Hardi-St/Zugzielanzeiger_mit_Arduino/Pic/OLED_Stehend_mit_Man.jpg

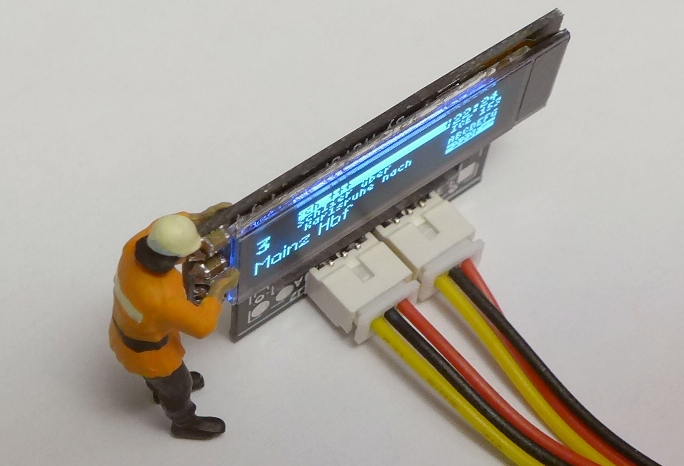
Pic/OLED_Stehend_mit_Man.jpg
