Hardi-St/Zugzielanzeiger_mit_Arduino/Pic/0.87 u 0.91 Zoll Display zusammen.jpg

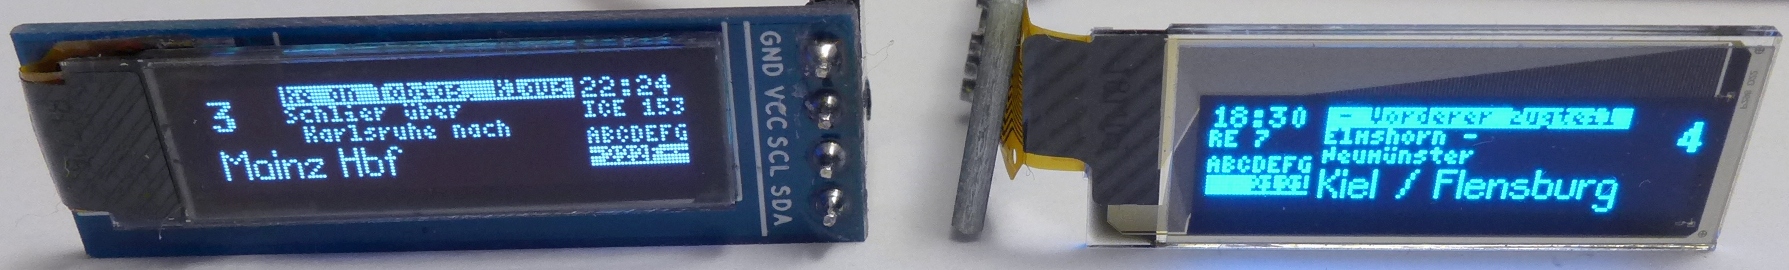
Pic/0.87 u 0.91 Zoll Display zusammen.jpg
