Hardi-St/Zugzielanzeiger_mit_Arduino/README.md

# Zugzielanzeiger_mit_Arduino
Zugzielanzeiger für den Bahnsteig mit Arduino und OLED Display

Siehe: https://www.stummiforum.de/viewtopic.php?f=21&t=131472
