Hardi-St/Zugzielanzeiger_mit_Arduino/Pic/0.87Zoll Disp v Hinten.jpg

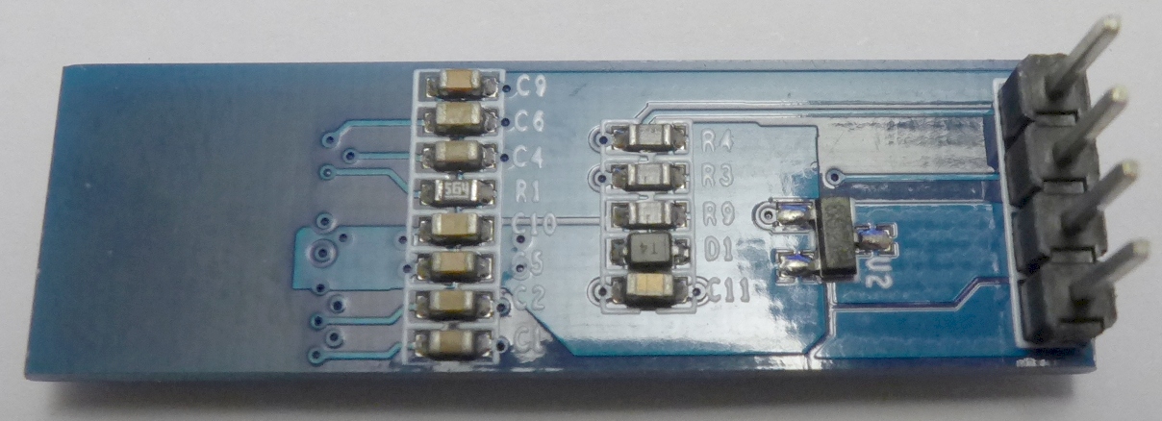
Pic/0.87Zoll Disp v Hinten.jpg
