Hardi-St/Zugzielanzeiger_mit_Arduino/Pic/0.91 Zoll Display.jpg

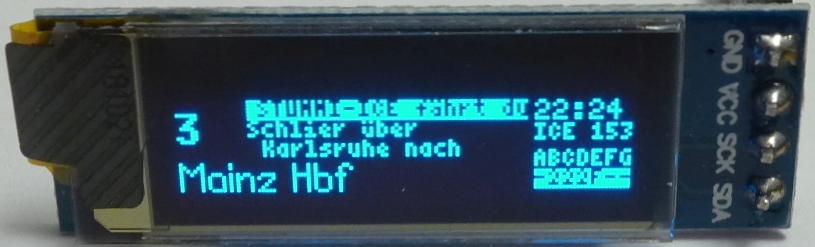
Pic/0.91 Zoll Display.jpg
