Hardi-St/Zugzielanzeiger_mit_Arduino/Pic/Dicke ein Display.PNG

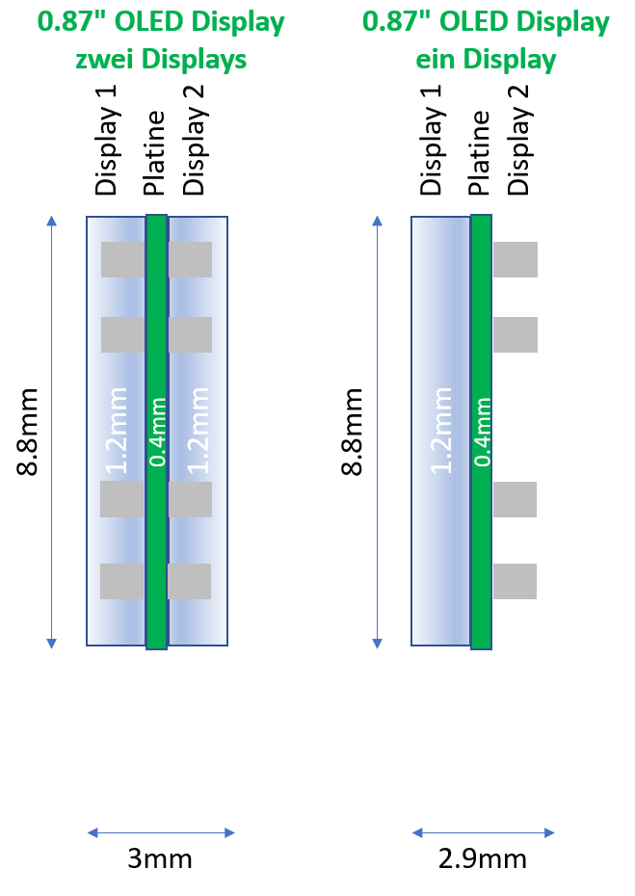
Pic/Dicke ein Display.PNG
