Hardi-St/Zugzielanzeiger_mit_Arduino/Pic/Größenvergleich.PNG

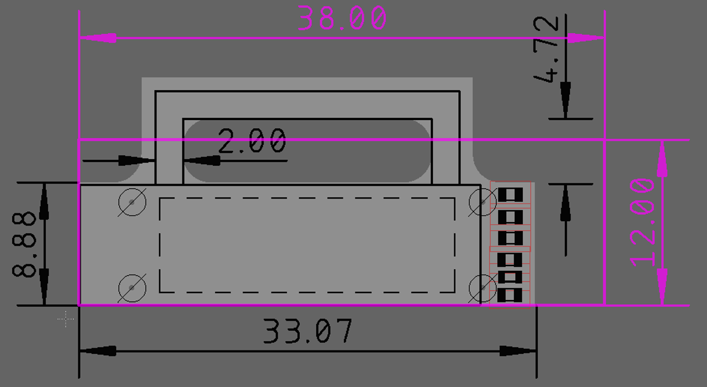
Pic/Größenvergleich.PNG
