Hardi-St/Zugzielanzeiger_mit_Arduino/Pic/OLED_Aufgeklappt.jpg

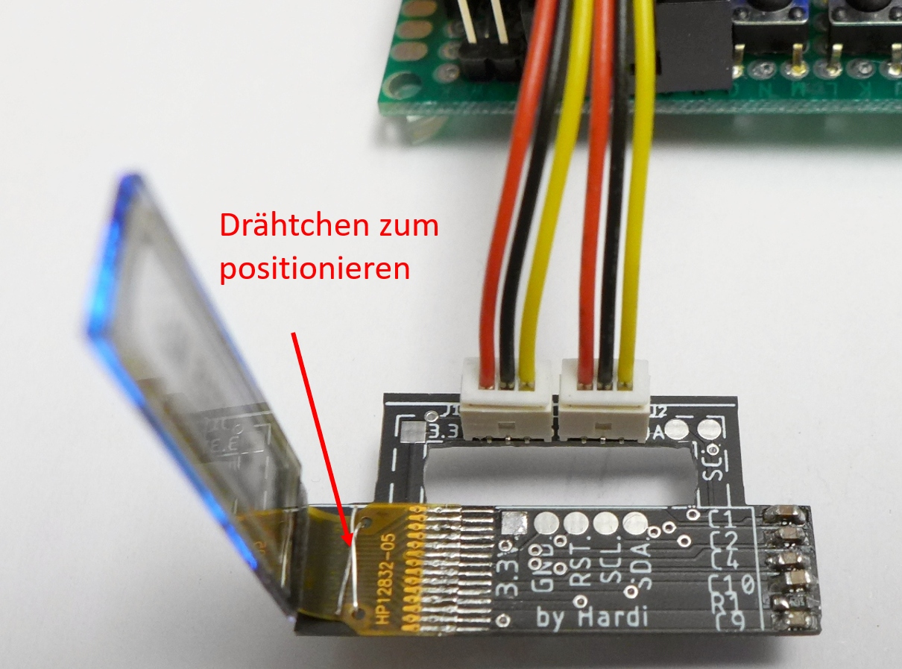
Pic/OLED_Aufgeklappt.jpg
