Hardi-St/Zugzielanzeiger_mit_Arduino/Pic/OLED_Bauteile_Umbau.PNG

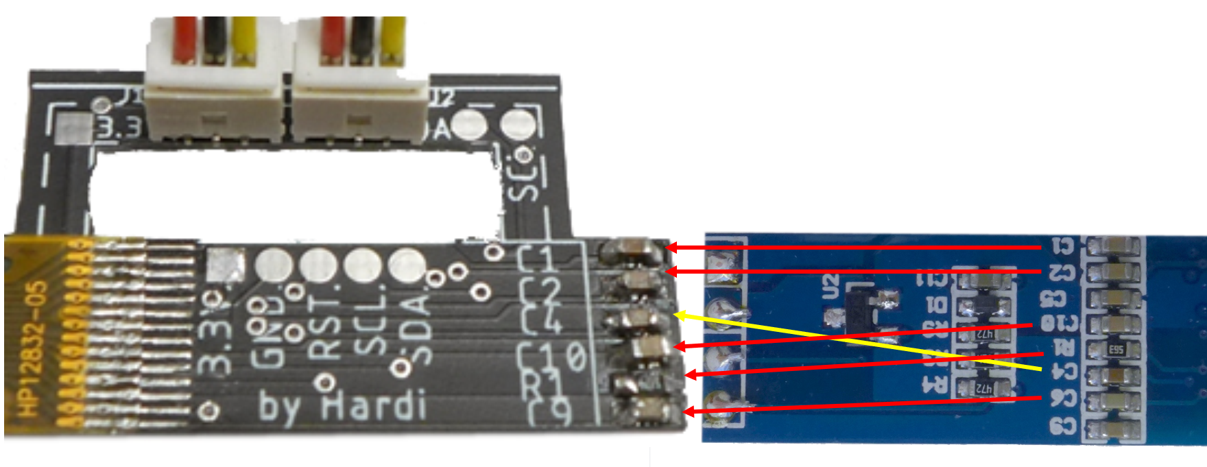
Pic/OLED_Bauteile_Umbau.PNG
