Hardi-St/Zugzielanzeiger_mit_Arduino/Pic/OLED_Umgeklappt.jpg

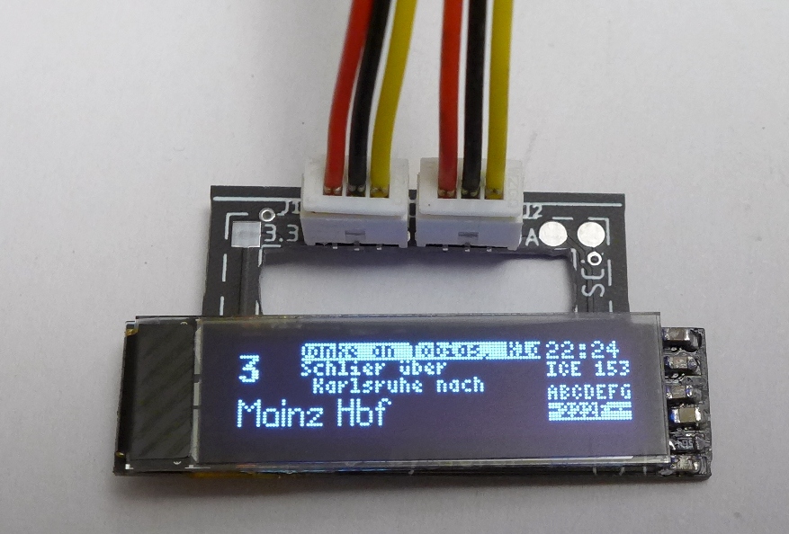
Pic/OLED_Umgeklappt.jpg
