Hardi-St/Zugzielanzeiger_mit_Arduino/Pic/OLED_von_Oben_mit_Mann.jpg

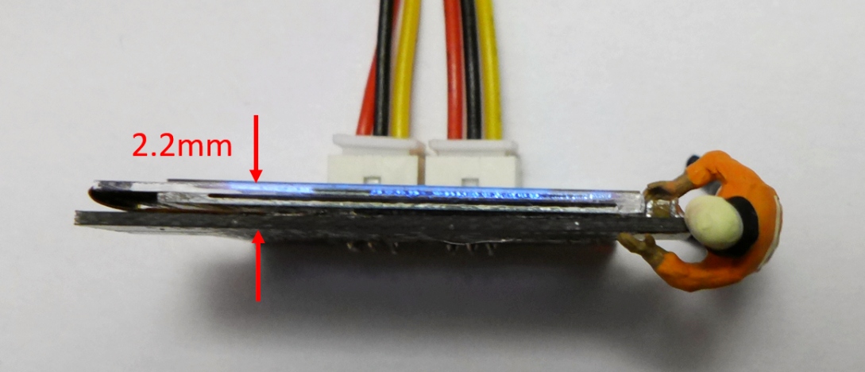
Pic/OLED_von_Oben_mit_Mann.jpg
