Hardi-St/Zugzielanzeiger_mit_Arduino/Pic/Vergleich Dicken.PNG

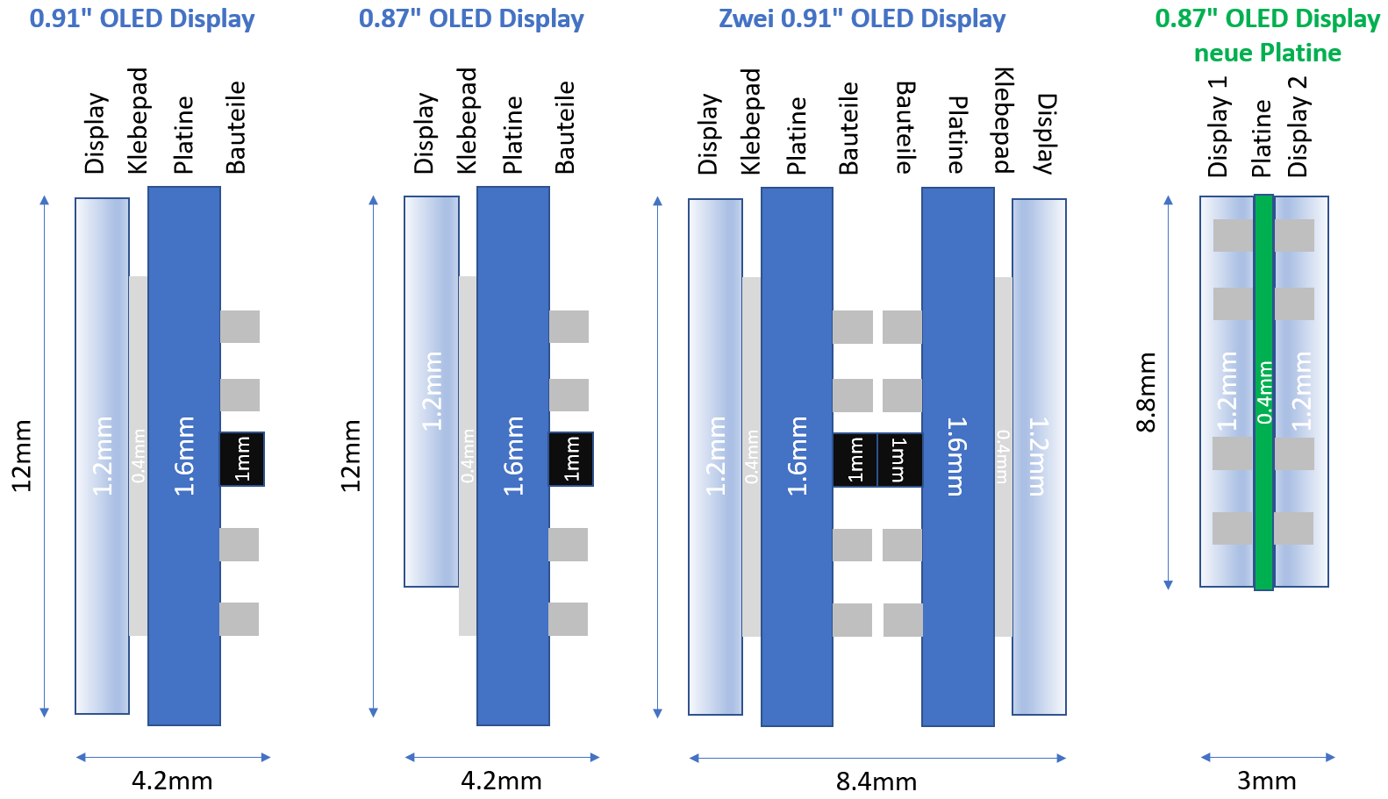
Pic/Vergleich Dicken.PNG
