Hardi-St/Zugzielanzeiger_mit_Arduino/Src/Beta/Bahnsteiganzeige_Hardi/Fonts/6x13B.jpg

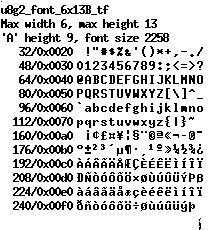
Src/Beta/Bahnsteiganzeige_Hardi/Fonts/6x13B.jpg
