Hardi-St/Zugzielanzeiger_mit_Arduino/Src/Beta/Bahnsteiganzeige_Hardi/Fonts/6x13B_german.jpg

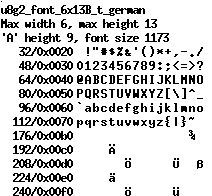
Src/Beta/Bahnsteiganzeige_Hardi/Fonts/6x13B_german.jpg
