Hardi-St/Zugzielanzeiger_mit_Arduino/3D-Gehause/Druckdaten-Zugzielanzeiger/mit_Griff/Case_2xDisplay_087.stl

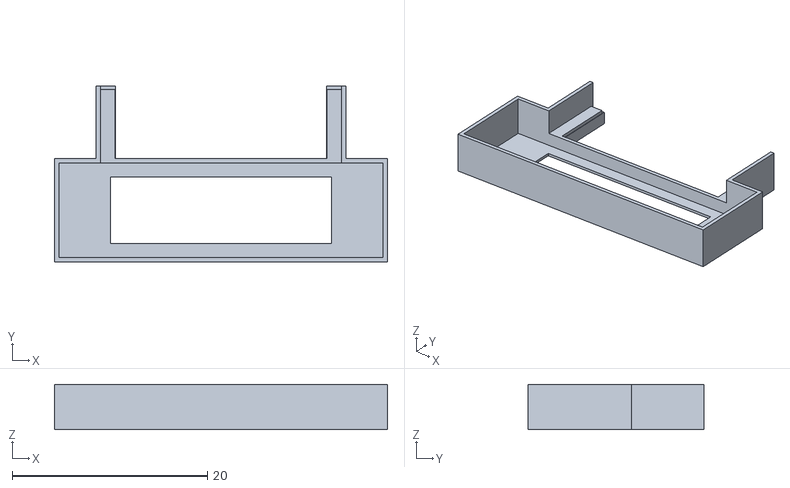
[picture p17: CAD file, 2020-10-04]
3D-Gehause/Druckdaten-Zugzielanzeiger/mit_Griff/Case_2xDisplay_087.stl
34.1 x 18.1 x 4.65
