Hardi-St/Zugzielanzeiger_mit_Arduino/3D-Gehause/Druckdaten-Zugzielanzeiger/mit_Griff/Cover_1xDisplay_087.stl

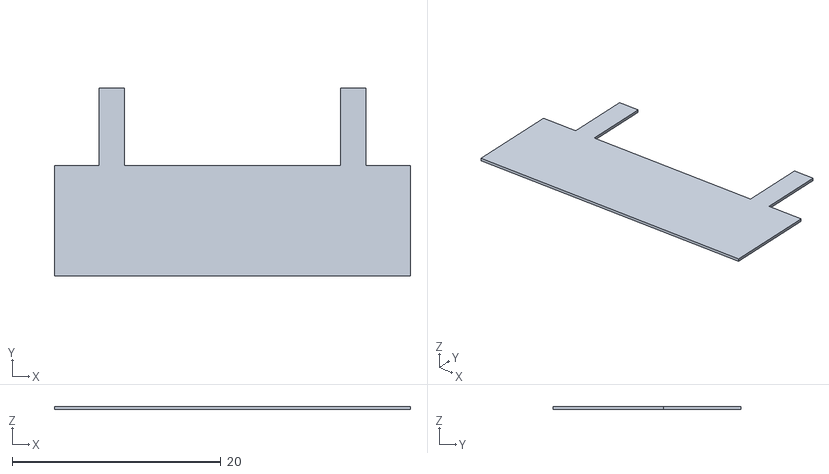
[picture p18: CAD file, 2020-10-04]
3D-Gehause/Druckdaten-Zugzielanzeiger/mit_Griff/Cover_1xDisplay_087.stl
34.1 x 18.1 x 0.3
