Hardi-St/Zugzielanzeiger_mit_Arduino/Platinen/Bestueckungsanleitungen/760DE_Bahnsteigs-Anzeige-OLED_mit_1x_Display.pdf

2021/03/30 13:03 | 1/11 | 760DE Bahnsteigs-Anzeige OLED mit 1 Display

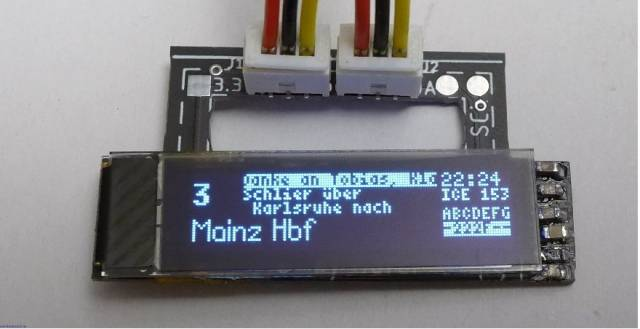
[picture p19: figure]

MobaLedLib Wiki - https://wiki.mobaledlib.de/

# 760DE Bahnsteigs-Anzeige OLED mit 1 Display

Last update: 2021/03/30 12:47 | anleitungen:oled:760de_1xdisplay https://wiki.mobaledlib.de/anleitungen/oled/760de_1xdisplay
https://wiki.mobaledlib.de/ | Printed on 2021/03/30 13:03

## Stückliste

Nachfolgend findet man die Stückliste der notwendigen Bauteile inkl der Bestellnummern bei Reichelt. Man kann allerdings auch anstelle dem einzelnen Display, ein Display mit Platine (https://de.aliexpress.com/item/4000182887362.html) kaufen und die notwendigen Bauteile von dieser ablöten und verwenden.

Anzahl Bezeichnung | | Beschreibung | Bestellnummer | Alternativen, Bemerkungen
1 | Board | Platine | ALF 760-BSt_Anzeige_OLED 1x Display
2 | C1, C2 | Vielschicht-Kerko, 1.0 µF, SMD-0603 | KEM X5R0603 1,0U (https://www.reichelt.de/vielschicht-kerko-1-0-f-25v-85-c-kem-x5r0603-1-0u-p207006.html)
1 | C4 | Vielschicht-Kerko, 2,2µF, 25V, SMD-0603 | KEM X5R0603 2,2U (https://www.reichelt.de/vielschicht-kerko-2-2-f-10v-85-c-kem-x5r0603-2-2u-p207007.html)
2 | C9, C10 | Vielschicht-Kerko, 4,7µF, 25V, SMD-0603 | KEM X5R0603 4,7U (https://www.reichelt.de/vielschicht-kerko-4-7-f-10v-85-c-kem-x5r0603-4-7u-p207009.html)
1 | R1 | SMD-Widerstand, 0603, 560 kOhm, 100mW | SMD-0603 560K (https://www.reichelt.de/smd-widerstand-0603-560-kohm-100-mw-1--smd-0603-560k-p89463.html)
1 | OLED1 | OLED display, 14pin, 128*32, IIC, 0,87 | AliExpress (https://de.aliexpress.com/item/32847458610.html)
2 | J1, J3 | JST Mini Micro, RM 1,25mm, 3-polig | AliExpress (https://de.aliexpress.com/item/32907978236.html) | Alternative: 1x JST Mini Micro, RM 1,25mm, 6-polig (https://de.aliexpress.com/item/32907978236.html)

2021/03/30 13:03 | 3/11 | 760DE Bahnsteigs-Anzeige OLED mit 1 Display

## Bestückung - Aufbauanleitung

Auslöten von der original Platine

Kondensatoren und Widerstände

Dieser Schritt ist nur notwendig, wenn man sich dafür entscheiden hat, die notwendigen Kondensatoren, Widerstände und das Display von der Komplettplatine zu verwenden. Das Entfernen der Bauteile von der Platine geht ganz leicht.
Dazu einfach das Lötzinn auf einer Seite schmelzen und mit Entlötlitze das flüssige Lötzinn entfernen. Nun kann man mit einer Pinzette das Bauteil greifen und auf der anderen Seite des Bauteils das Lötzinn verflüssigen und das Bauteil vorsichtig abheben. Danach unbedingt merken welches Bauteil es war oder in einen Behälter mit Deckel und Beschriftung geben. Die Kondensatoren sind leider nicht ausreichend beschriftet um zu erkennen, welchen Wert diese haben.

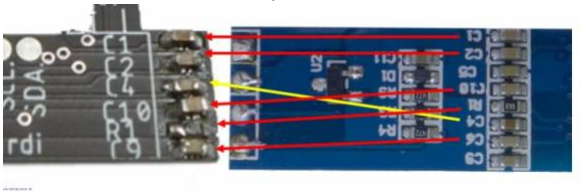
[picture p20: figure]

Display

Das ablöten des Displays ist gar kein Problem. Zum auslöten verzinnt man die Kontakte noch mal neu und erwärmt dann mehrere gleichzeitig vom Rand aus während man die Flexleiterplatte vorsichtig anhebt.

Bearbeiten der Platine

Damit die Platine in die dünnen Halterungen der Bahnsteiganzeige passt, muss die Platine mit einer guten und kleinen Schlüsselfeile bearbeitet werden. Dies ist notwendig, da der Hersteller der Platinen keine Rundungen kleiner 4mm ausfräsen kann. Auf dem nachfolgenden Bild ist oben die Platine im Originalzustand, unten die bereits bearbeitete Platine. Besondere vorsichtig ist an der Oberseite der Platine zu beachten. Dort liegen die Leiterbahnen sehr dicht an der Außenseite und können daher leicht beschädigt werden.

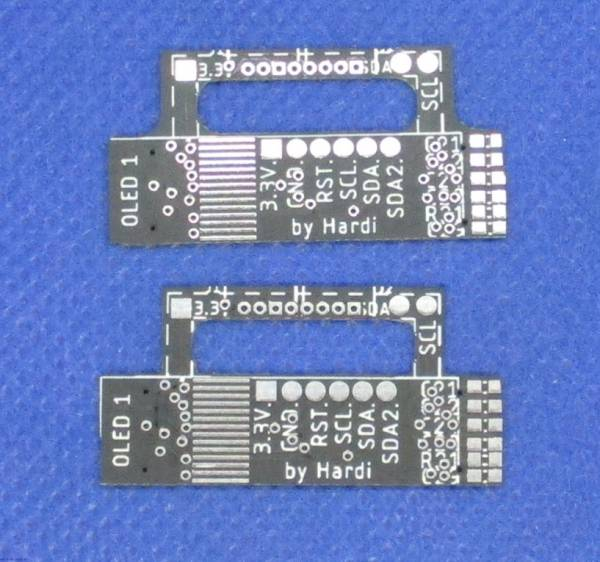
[picture p21: figure]
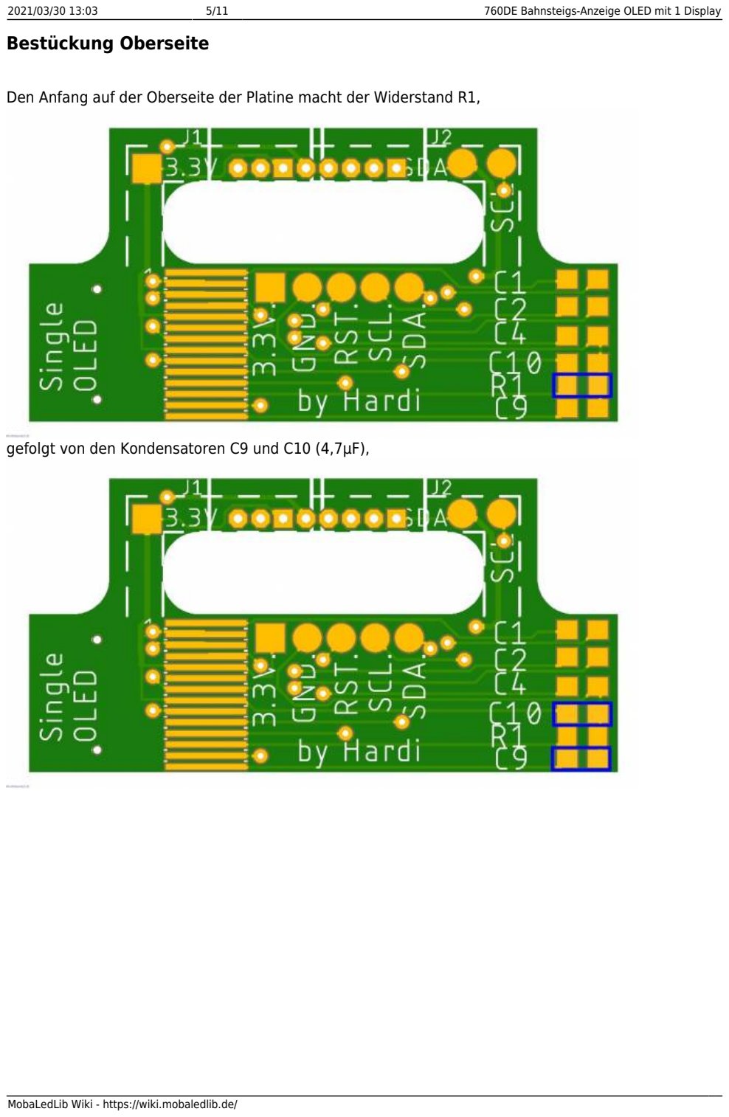
[picture p22: page 5]

2021/03/30 13:03 | 5/11 | 760DE Bahnsteigs-Anzeige OLED mit 1 Display
Bestückung Oberseite

Den Anfang auf der Oberseite der Platine macht der Widerstand R1,

gefolgt von den Kondensatoren C9 und C10 (4,7µF),

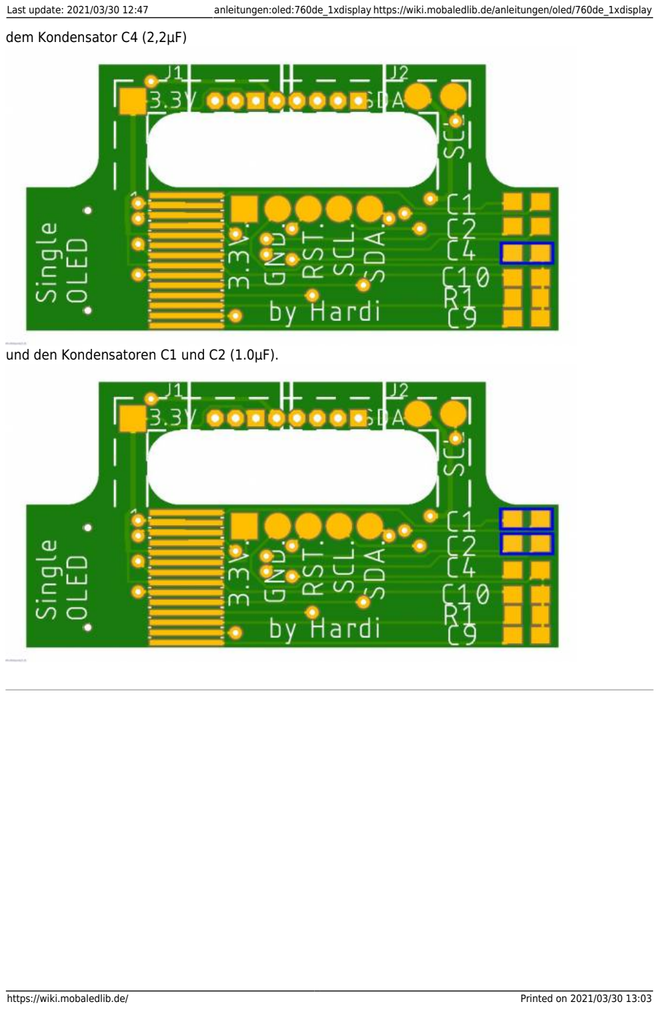
[picture p23: page 6]

dem Kondensator C4 (2,2µF)

und den Kondensatoren C1 und C2 (1.0µF).

2021/03/30 13:03 | 7/11 | 760DE Bahnsteigs-Anzeige OLED mit 1 Display

Sollte zwischen den Kontakten der Leiterbahn ein Verbindung durch Lötzinn entstehen, das Lötzinn mit einer schnellen Bewegung des Lötkolbens in Richtung der Platinenmitte wegschieben. Dort ist ein entfernen des überschüssigen Lötzinns ohne größere Problem möglich.

Zum Anlöten wurden auf der Platine zwei kleine Löcher vorgesehen durch die man einen Draht steckt. Mit diesen wird dann das Displayflexkabel an der richtigen Position fixiert. Dann muss man nur noch winzige Korrekturen machen und kann die Leiterbahnen verbinden. Dazu mit der obersten Leiterbahn beginnen und schauen das diese nach dem anlöten noch sauber ausgerichtet ist. Erst nachdem die Position passt, kann die nächsten Kontakte mit winzigen Mengen Zinn verlöten.

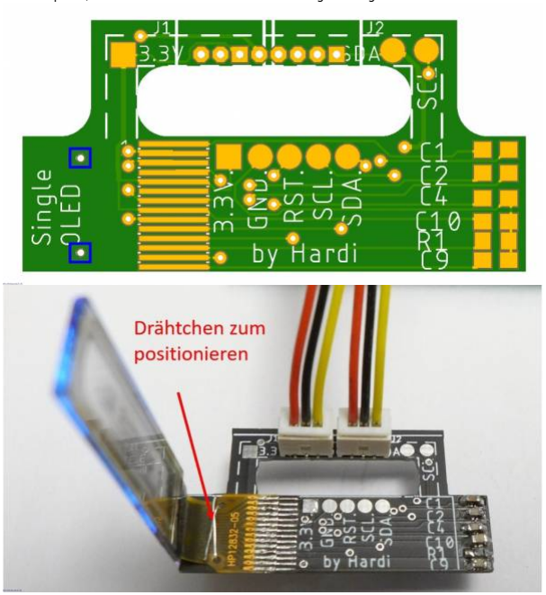
[picture p24: figure]
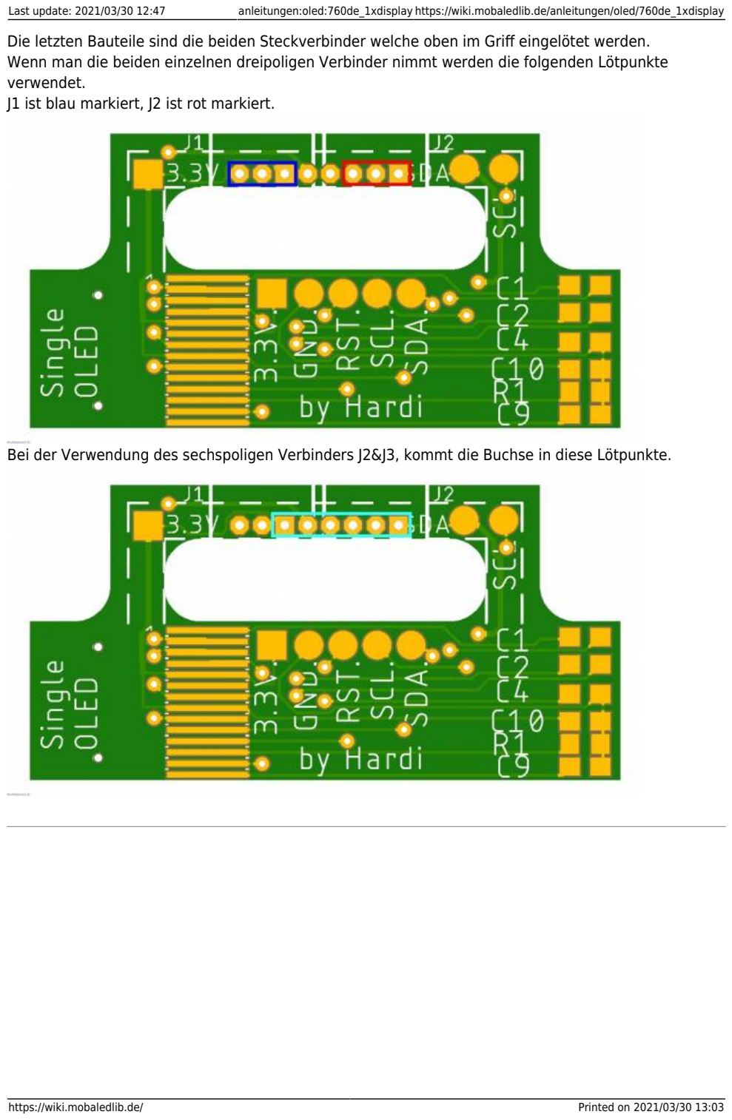
[picture p25: page 8]

Die letzten Bauteile sind die beiden Steckverbinder welche oben im Griff eingelötet werden. Wenn man die beiden einzelnen dreipoligen Verbinder nimmt werden die folgenden Lötpunkte verwendet.
J1 ist blau markiert, J2 ist rot markiert.

Bei der Verwendung des sechspoligen Verbinders J2&J3, kommt die Buchse in diese Lötpunkte.

2021/03/30 13:03 | 9/11 | 760DE Bahnsteigs-Anzeige OLED mit 1 Display
Die Belegung der Kontakt ist wie auf dem nachfolgenden Bildern beschrieben. SDA2 wird dabei für die Platine mit 1x Display nicht benötigt und muss nicht verbunden werden.

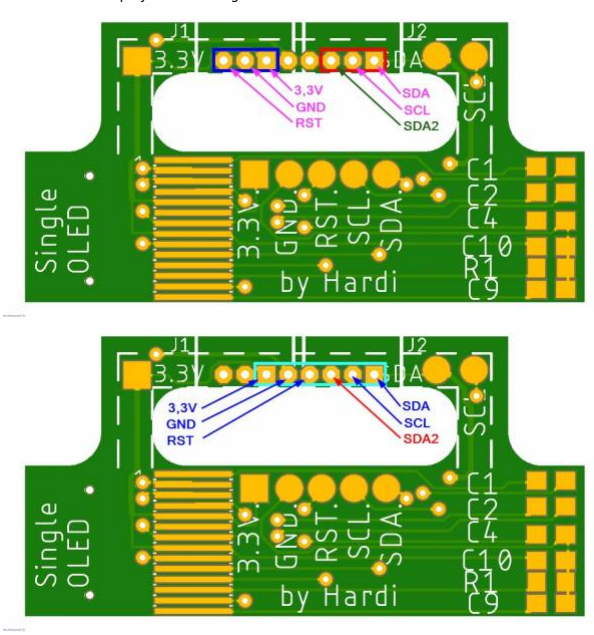
[picture p26: figure]
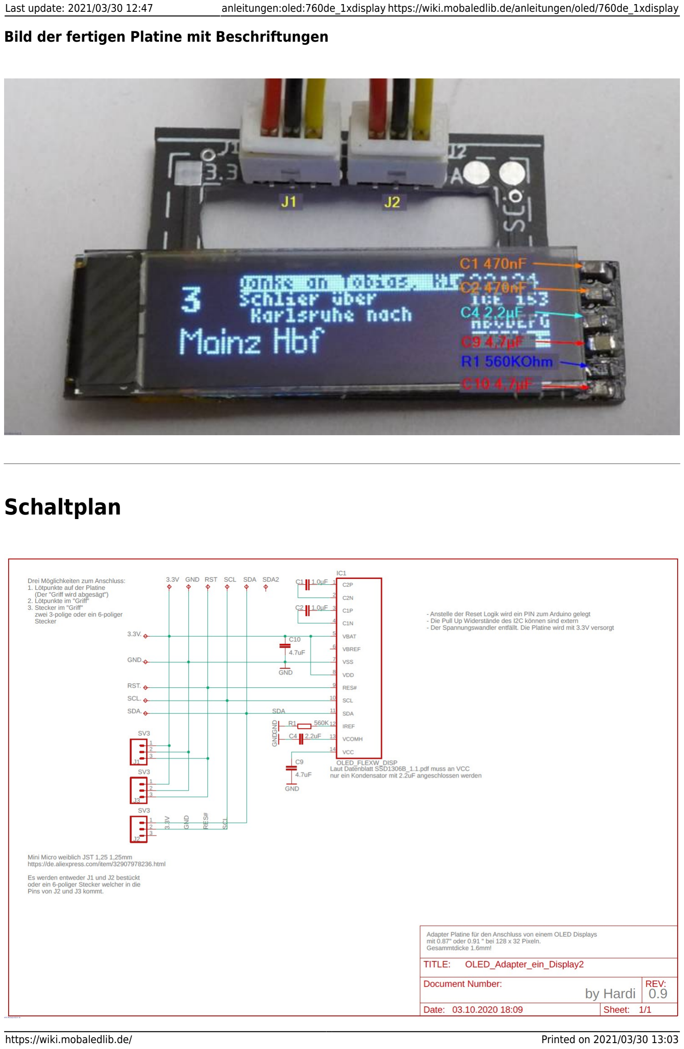
[picture p27: page 10]

Bild der fertigen Platine mit Beschriftungen

## Schaltplan

2021/03/30 13:03 | 11/11 | 760DE Bahnsteigs-Anzeige OLED mit 1 Display

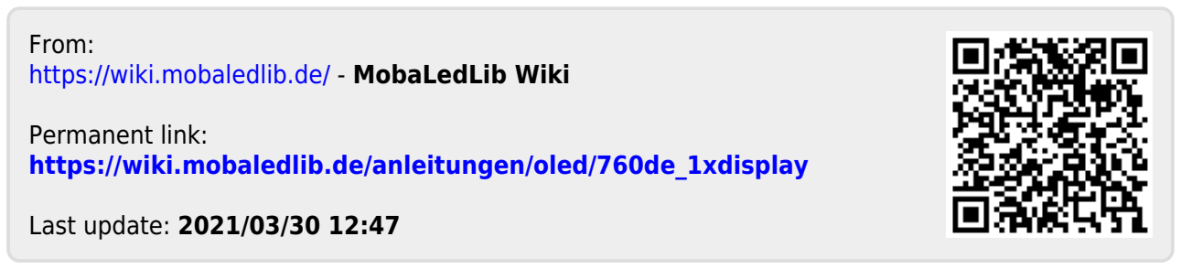
[picture p28: figure]
From: https://wiki.mobaledlib.de/ - MobaLedLib Wiki; Permanent link: https://wiki.mobaledlib.de/anleitungen/oled/760de_1xdisplay; Last update: 2021/03/30 12:47
