Hardi-St/Zugzielanzeiger_mit_Arduino/Platinen/Bestueckungsanleitungen/760DE_Bahnsteigs-Anzeige-OLED_mit_2x_Display.pdf

2021/03/28 08:15 | 1/14 | 760DE Bahnsteigs-Anzeige OLED mit 2 Display

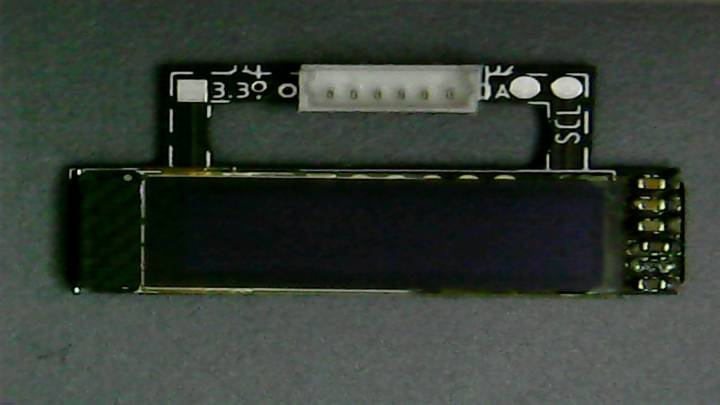
[picture p29: figure]

MobaLedLib Wiki - https://wiki.mobaledlib.de/

# 760DE Bahnsteigs-Anzeige OLED mit 2 Display

Last update: 2021/03/28 08:15 | anleitungen:oled:760de_2xdisplay https://wiki.mobaledlib.de/anleitungen/oled/760de_2xdisplay
https://wiki.mobaledlib.de/ | Printed on 2021/03/28 08:15

## Stückliste

Nachfolgend findet man die Stückliste der notwendigen Bauteile inkl der Bestellnummern bei Reichelt. Man kann allerdings auch anstelle dem einzelnen Display, ein Display mit Platine (https://de.aliexpress.com/item/4000182887362.html) kaufen und die notwendigen Bauteile von dieser ablöten und verwenden.

Anzahl | Bezeichnung | Beschreibung | Bestellnummer | Alternativen, Bemerkungen
1 | Board | Platine | ALF 760-BSt_Anzeige_OLED 1x Display
4 | C1, C2, C21, C22 | Vielschicht-Kerko, 1.0 µF, SMD-0603 | KEM X5R0603 1,0U (https://www.reichelt.de/vielschicht-kerko-1-0-f-25v-85-c-kem-x5r0603-1-0u-p207006.html)
2 | C4, C24 | Vielschicht-Kerko, 2,2µF, SMD-0603 | KEM X5R0603 2,2U (https://www.reichelt.de/vielschicht-kerko-2-2-f-10v-85-c-kem-x5r0603-2-2u-p207007.html)
4 | C9, C10, C20, C29 | Vielschicht-Kerko, 4,7µF, 25V, SMD-0603 | KEM X5R0603 4,7U (https://www.reichelt.de/vielschicht-kerko-4-7-f-10v-85-c-kem-x5r0603-4-7u-p207009.html)
2 | R1, R21 | SMD-Widerstand, 560K, SMD-0603, 100mW | SMD-0603 560K (https://www.reichelt.de/smd-widerstand-0603-560-kohm-100-mw-1--smd-0603-560k-p89463.html)
2 | OLED1 | OLED display, 14pin, 128*32, IIC, 0,87 | AliExpress (https://de.aliexpress.com/item/32847458610.html)
2 | J1, J3 | JST Mini Micro, RM 1,25mm, 3-polig | AliExpress (https://de.aliexpress.com/item/32907978236.html) | Alternative: 1x JST Mini Micro, RM 1,25mm, 6-polig (https://de.aliexpress.com/item/32907978236.html)

2021/03/28 08:15 | 3/14 | 760DE Bahnsteigs-Anzeige OLED mit 2 Display

## Bestückung - Aufbauanleitung

Die Bestückung der Platine muss beidseitig mit allen SMD-Bauteilen erfolgen, auch wenn nur ein Display verwendet werden möchte. Wenn man nur 1 Display haben möchte, kann man auch diese Variante (https://wiki.mobaledlib.de/anleitungen/oled/760de_1xdisplay) verwenden.

Auslöten von der original Platine

Kondensatoren und Widerstände

Dieser Schritt ist nur notwendig, wenn man sich dafür entscheiden hat, die notwendigen Kondensatoren, Widerstände und das Display von der Komplettplatine zu verwenden. Das Entfernen der Bauteile von der Platine geht ganz leicht.
Dazu einfach das Lötzinn auf einer Seite schmelzen und mit Entlötlitze das flüssige Lötzinn entfernen. Nun kann man mit einer Pinzette das Bauteil greifen und auf der anderen Seite des Bauteils das Lötzinn verflüssigen und das Bauteil vorsichtig abheben. Danach unbedingt merken welches Bauteil es war oder in einen Behälter mit Deckel und Beschriftung geben. Die Kondensatoren sind leider nicht ausreichend beschriftet um zu erkennen, welchen Wert diese haben.

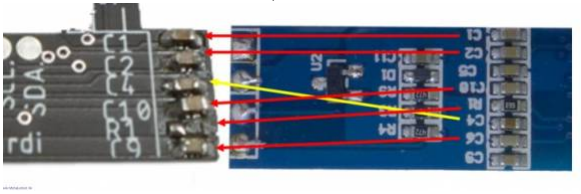
[picture p30: figure]

Display

Das ablöten des Displays ist gar kein Problem. Zum auslöten verzinnt man die Kontakte noch mal neu und erwärmt dann mehrere gleichzeitig vom Rand aus während man die Flexleiterplatte vorsichtig anhebt.

Bearbeiten der Platine

Damit die Platine in die dünnen Halterungen der Bahnsteiganzeige passt, muss die Platine mit einer guten und kleinen Schlüsselfeile bearbeitet werden. Dies ist notwendig, da der Hersteller der Platinen keine Rundungen kleiner 4mm ausfräsen kann. Auf dem nachfolgenden Bild ist oben die Platine im Originalzustand, unten die bereits bearbeitete Platine. Besondere vorsichtig ist an der Oberseite der Platine zu beachten. Dort liegen die Leiterbahnen sehr dicht an der Außenseite und können daher leicht beschädigt werden.

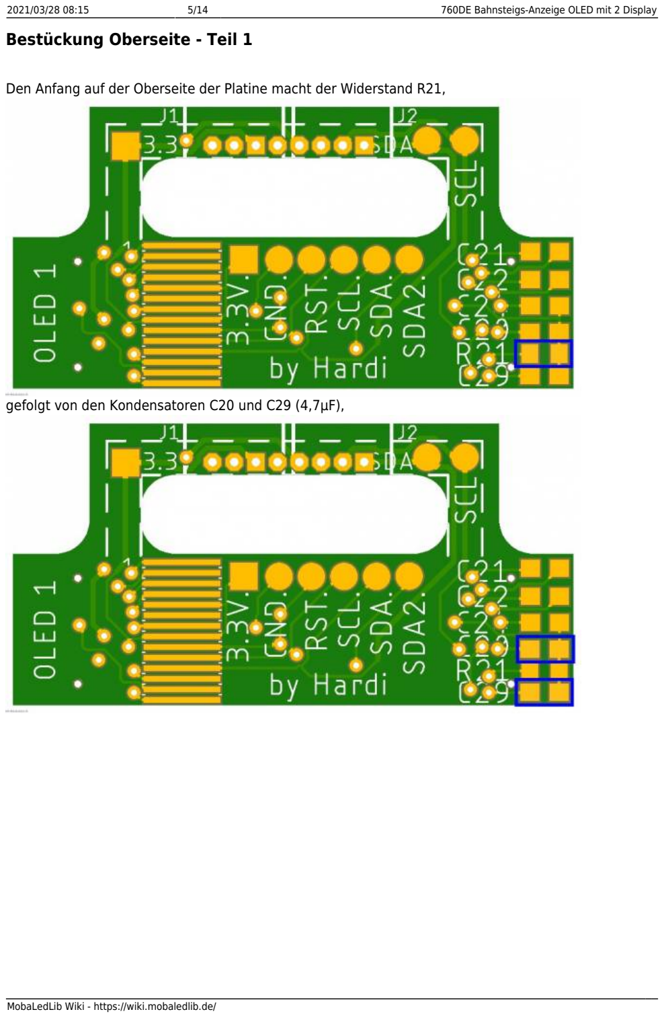
[picture p31: page 5]

2021/03/28 08:15 | 5/14 | 760DE Bahnsteigs-Anzeige OLED mit 2 Display
Bestückung Oberseite - Teil 1

Den Anfang auf der Oberseite der Platine macht der Widerstand R21,

gefolgt von den Kondensatoren C20 und C29 (4,7µF),

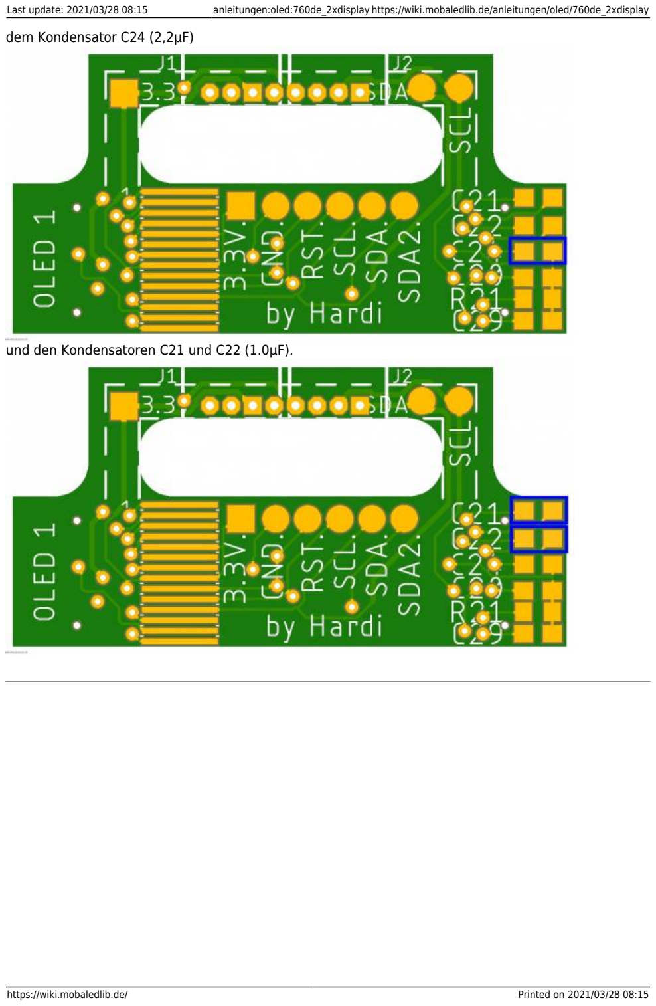
[picture p32: page 6]

dem Kondensator C24 (2,2µF)

und den Kondensatoren C21 und C22 (1.0µF).

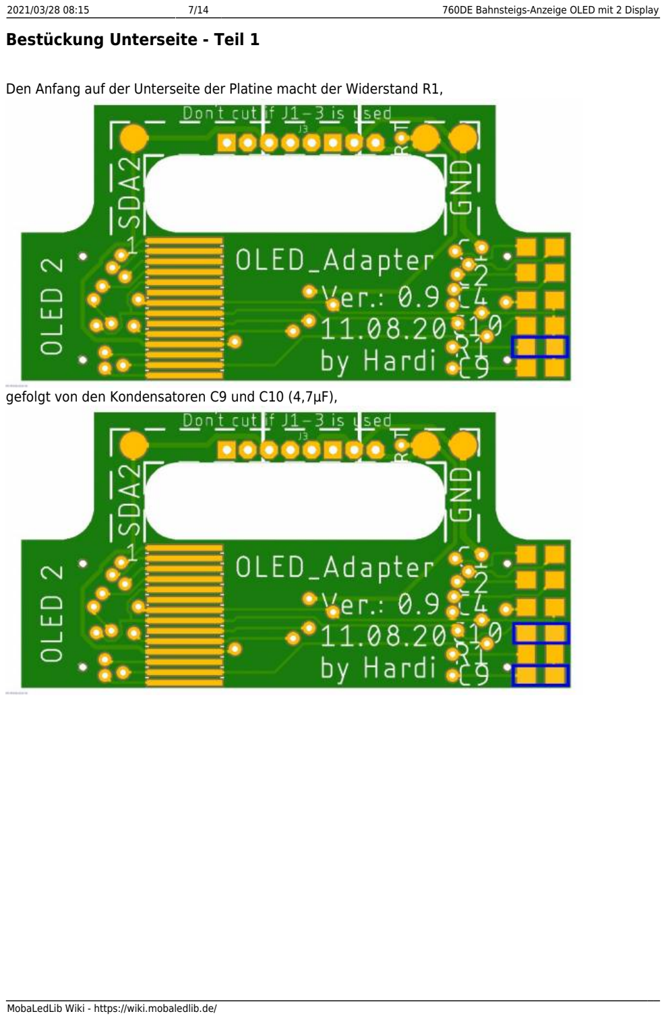
[picture p33: page 7]

2021/03/28 08:15 | 7/14 | 760DE Bahnsteigs-Anzeige OLED mit 2 Display
Bestückung Unterseite - Teil 1

Den Anfang auf der Unterseite der Platine macht der Widerstand R1,

gefolgt von den Kondensatoren C9 und C10 (4,7µF),

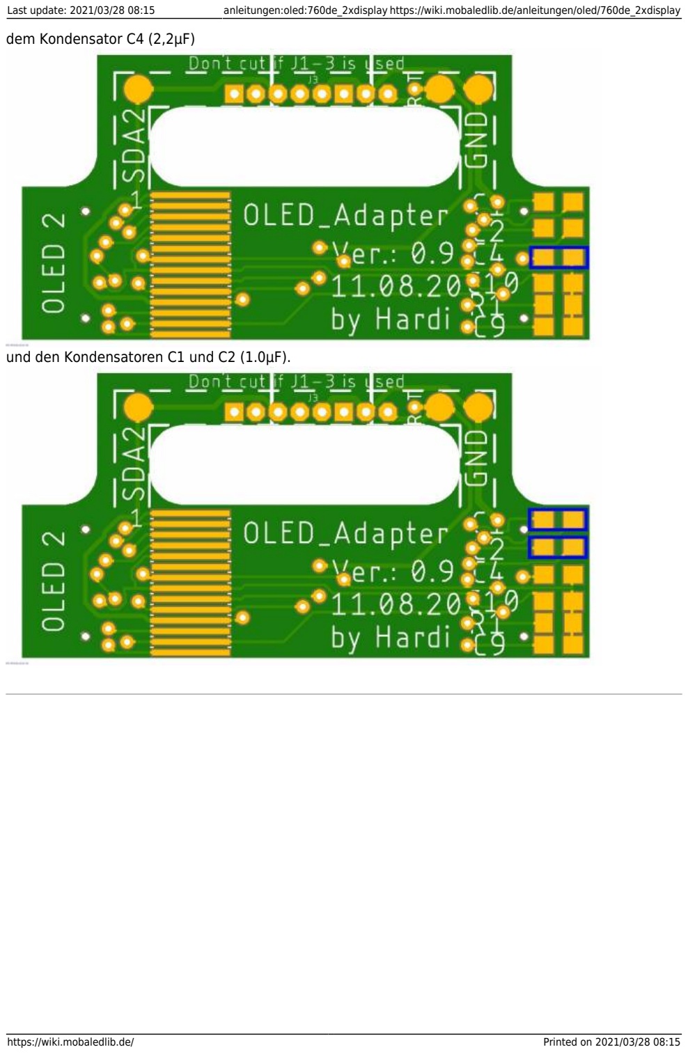
[picture p34: page 8]

dem Kondensator C4 (2,2µF)

und den Kondensatoren C1 und C2 (1.0µF).

2021/03/28 08:15 | 9/14 | 760DE Bahnsteigs-Anzeige OLED mit 2 Display
Bestückung Oberseite - Teil 2 - Display
1. Den Draht zum fixieren des flexiblen Anschlusskabels erst entfernen, wenn beide Displays angelötet sind, um die Lötstellen und die Leiterbahnen zu entlasten.
2. Sollte zwischen den Kontakten der Leiterbahn ein Verbindung durch Lötzinn entstehen das Lötzinn mit einer schnellen Bewegung des Lötkolbens in Richtung der Platinenmitte wegschieben. Dort ist ein entfernen des überschüssigen Lötzinns ohne größere Problem möglich.

Zum Anlöten wurden auf der jeder Seite der Platine zwei kleine Löcher vorgesehen durch die man einen Draht stecken kann. Mit diesen wird dann das Displayflexkabel an der richtigen Position fixiert. Dann muss man nur noch winzige Korrekturen machen und kann die Leiterbahnen verbinden. Dazu mit der obersten Leiterbahn beginnen und schauen das diese nach dem anlöten noch sauber ausgerichtet ist. Erst nachdem die Position passt, kann die nächsten Kontakte mit winzigen Mengen Zinn verlöten.

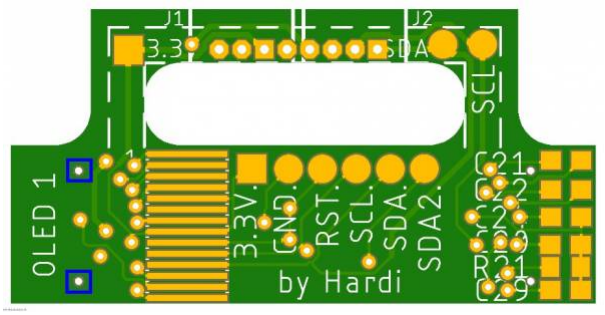
[picture p35: figure]

Bestückung Unterseite - Teil 2 - Display

Wie auch auf der Oberseite gibt es hier Löcher für die Fixierung des Flexleiters. Denn Anfang macht wieder die obersten Leiterbahn. Wenn von dieser nach dem festlöten die Position passt, kann mit den andern Kontakte weitergemacht werden.

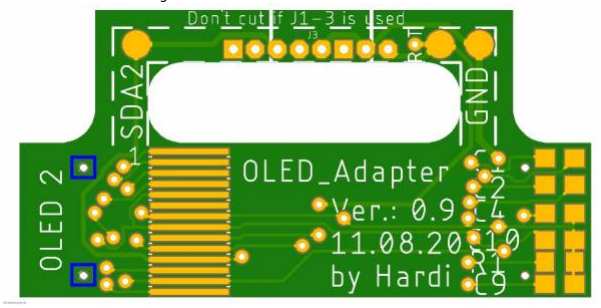
[picture p36: figure]
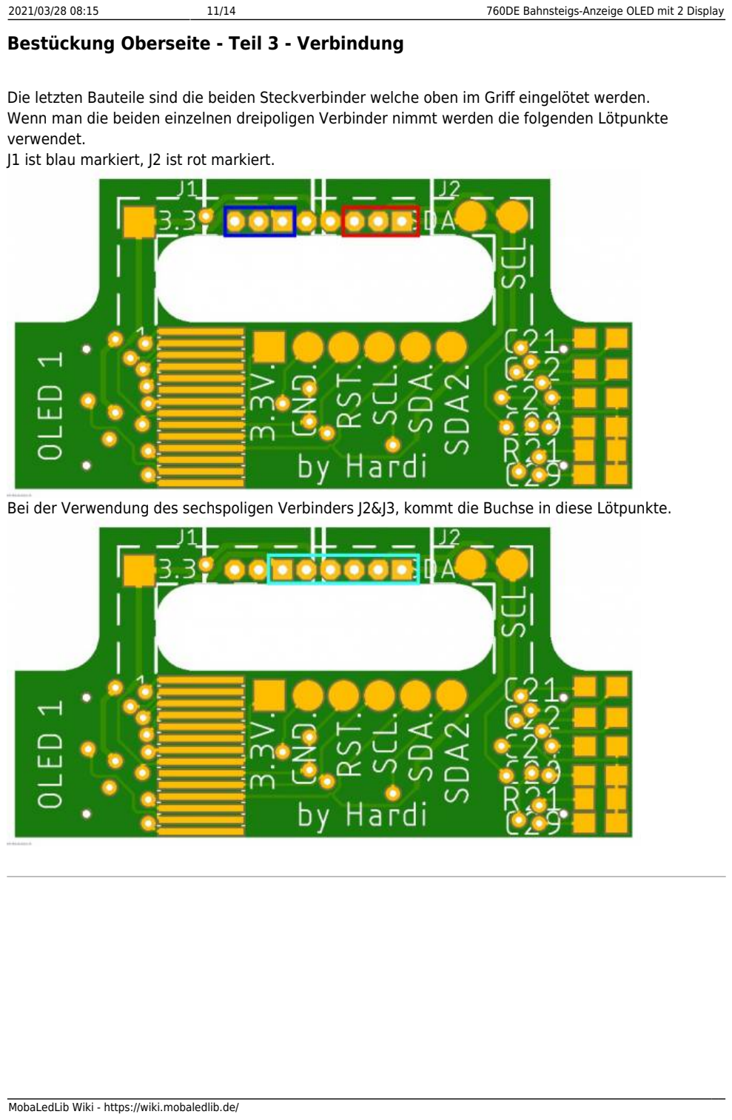
[picture p37: page 11]

2021/03/28 08:15 | 11/14 | 760DE Bahnsteigs-Anzeige OLED mit 2 Display
Bestückung Oberseite - Teil 3 - Verbindung

Die letzten Bauteile sind die beiden Steckverbinder welche oben im Griff eingelötet werden.
Wenn man die beiden einzelnen dreipoligen Verbinder nimmt werden die folgenden Lötpunkte verwendet.
J1 ist blau markiert, J2 ist rot markiert.

Bei der Verwendung des sechspoligen Verbinders J2&J3, kommt die Buchse in diese Lötpunkte.

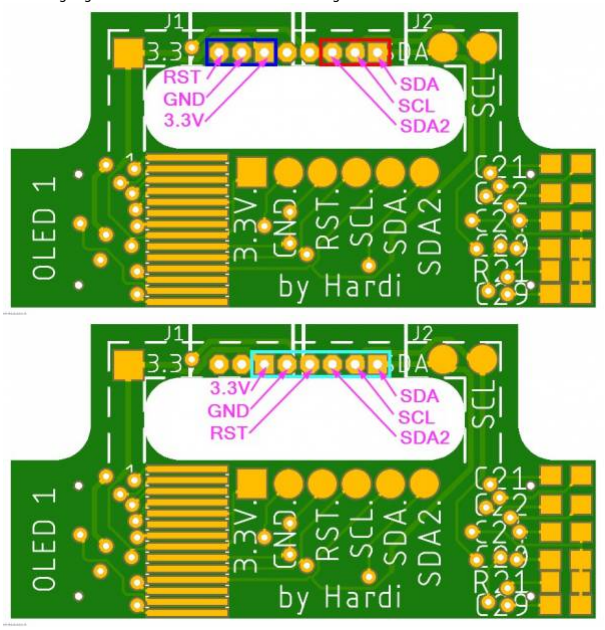
[picture p38: figure]

Die Belegung der Kontakt ist wie auf dem nachfolgenden Bildern beschrieben.

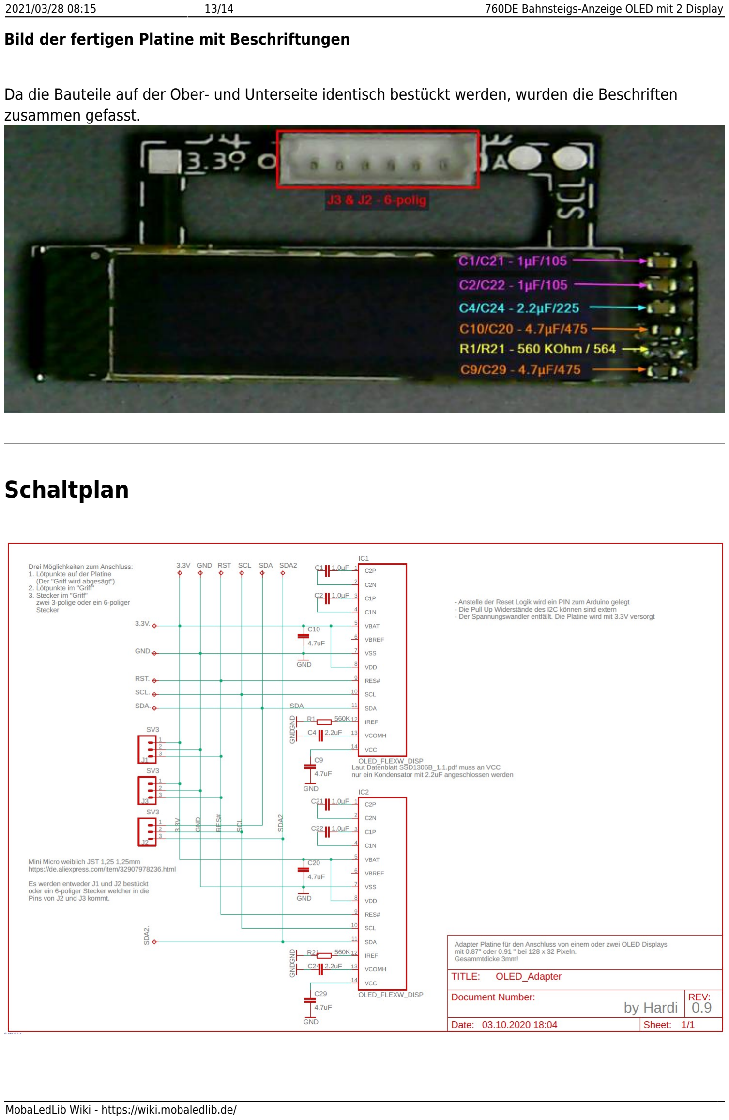
[picture p39: page 13]

2021/03/28 08:15 | 13/14 | 760DE Bahnsteigs-Anzeige OLED mit 2 Display
Bild der fertigen Platine mit Beschriftungen

Da die Bauteile auf der Ober- und Unterseite identisch bestückt werden, wurden die Beschriften zusammen gefasst.

## Schaltplan

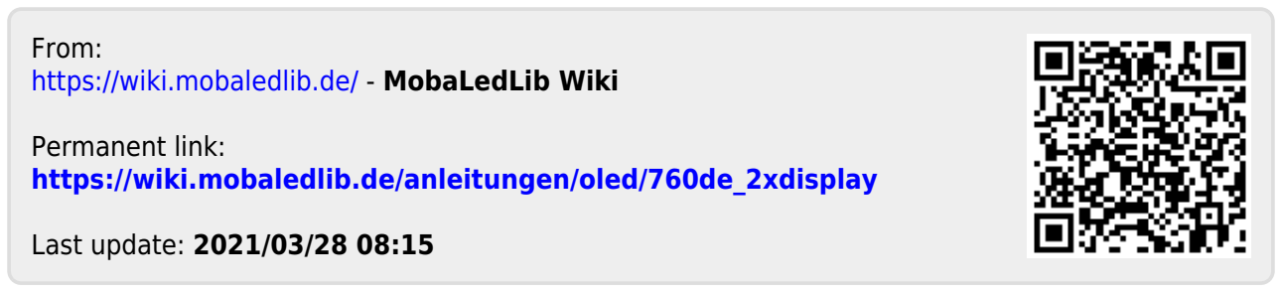
[picture p40: figure]
From: https://wiki.mobaledlib.de/ - MobaLedLib Wiki; Permanent link: https://wiki.mobaledlib.de/anleitungen/oled/760de_2xdisplay; Last update: 2021/03/28 08:15
