Hardi-St/Zugzielanzeiger_mit_Arduino/Platinen/Eigene OLED Platine/OLED_Adapter_Alle_Bauteile.pdf

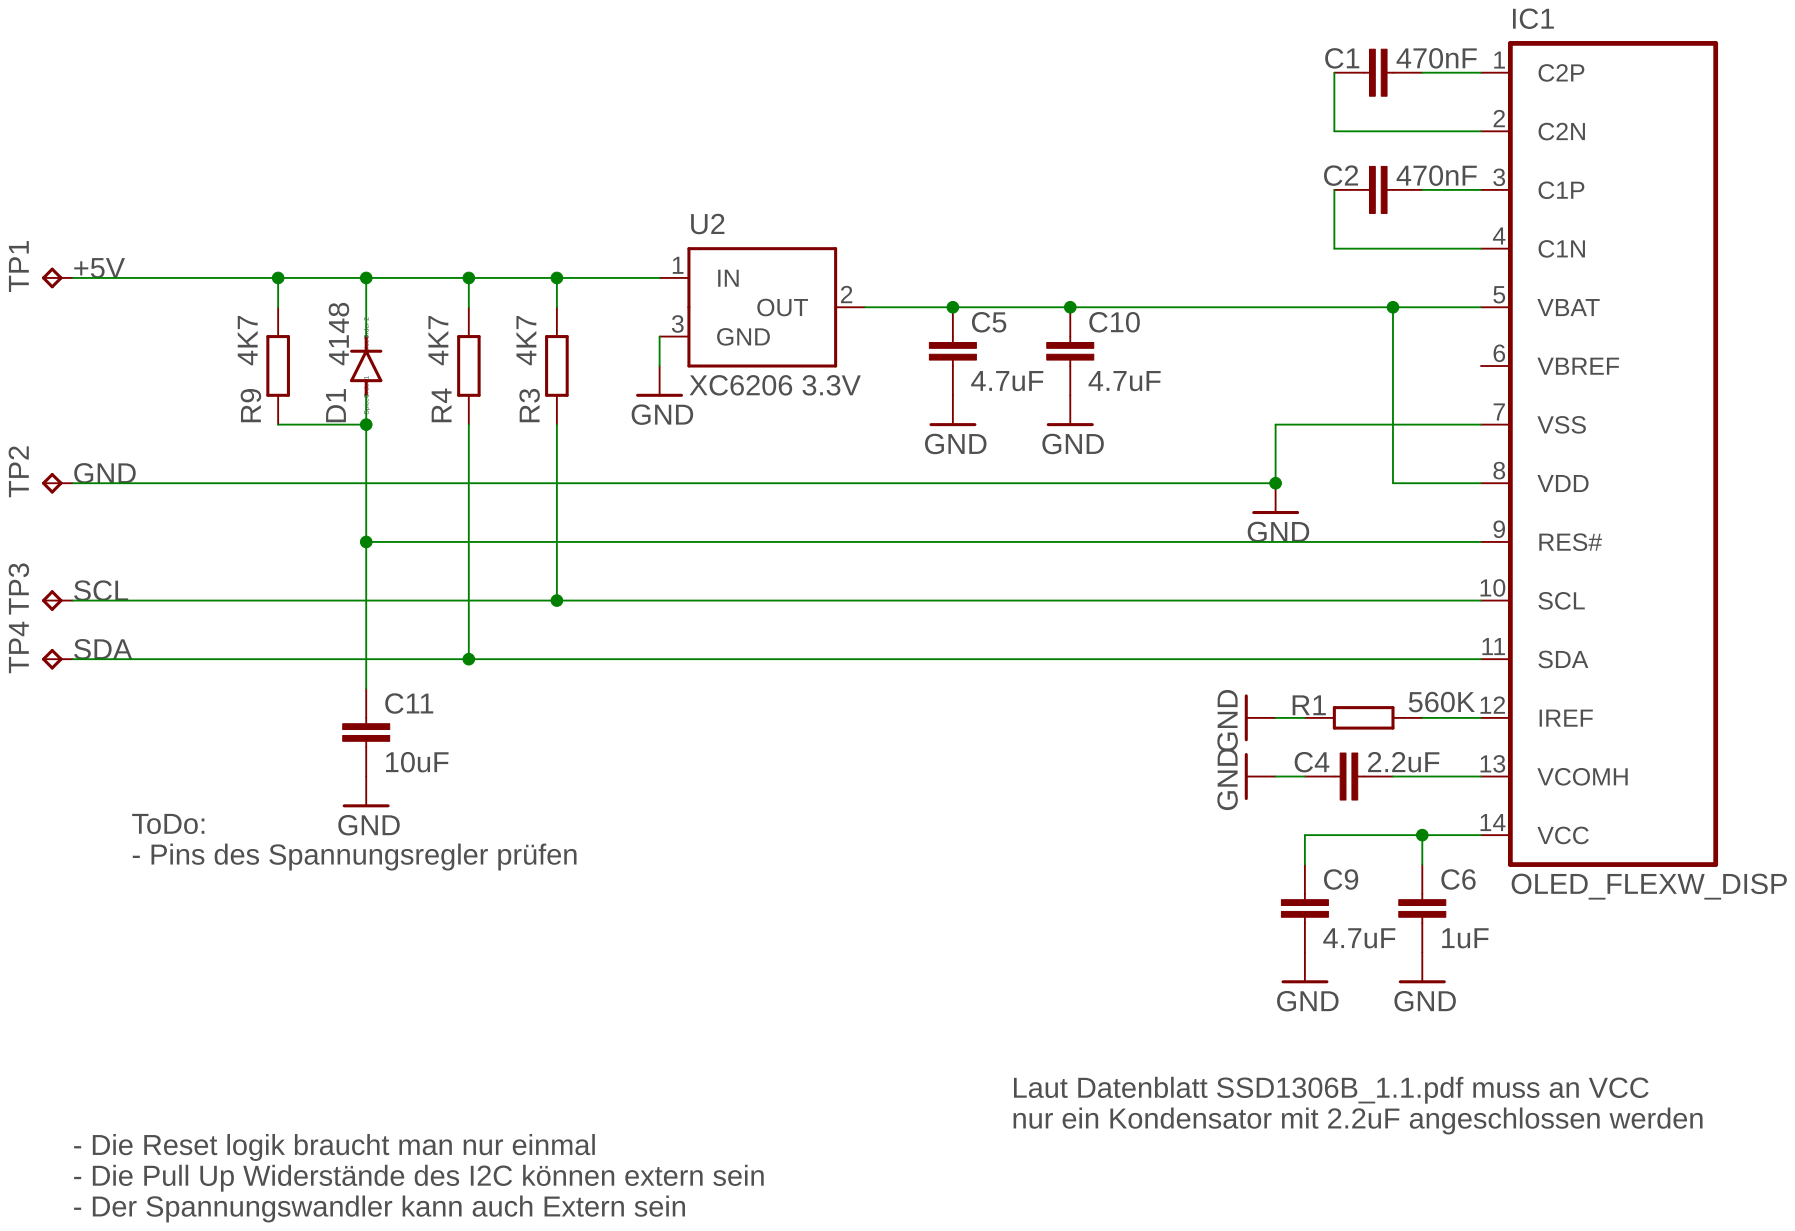
[picture p41: page 1]
