Hardi-St/Zugzielanzeiger_mit_Arduino/Platinen/Eigene OLED Platine/OLED_Adapter.brd

## EAGLE design Platinen/Eigene OLED Platine/OLED_Adapter.brd (2020-10-03)

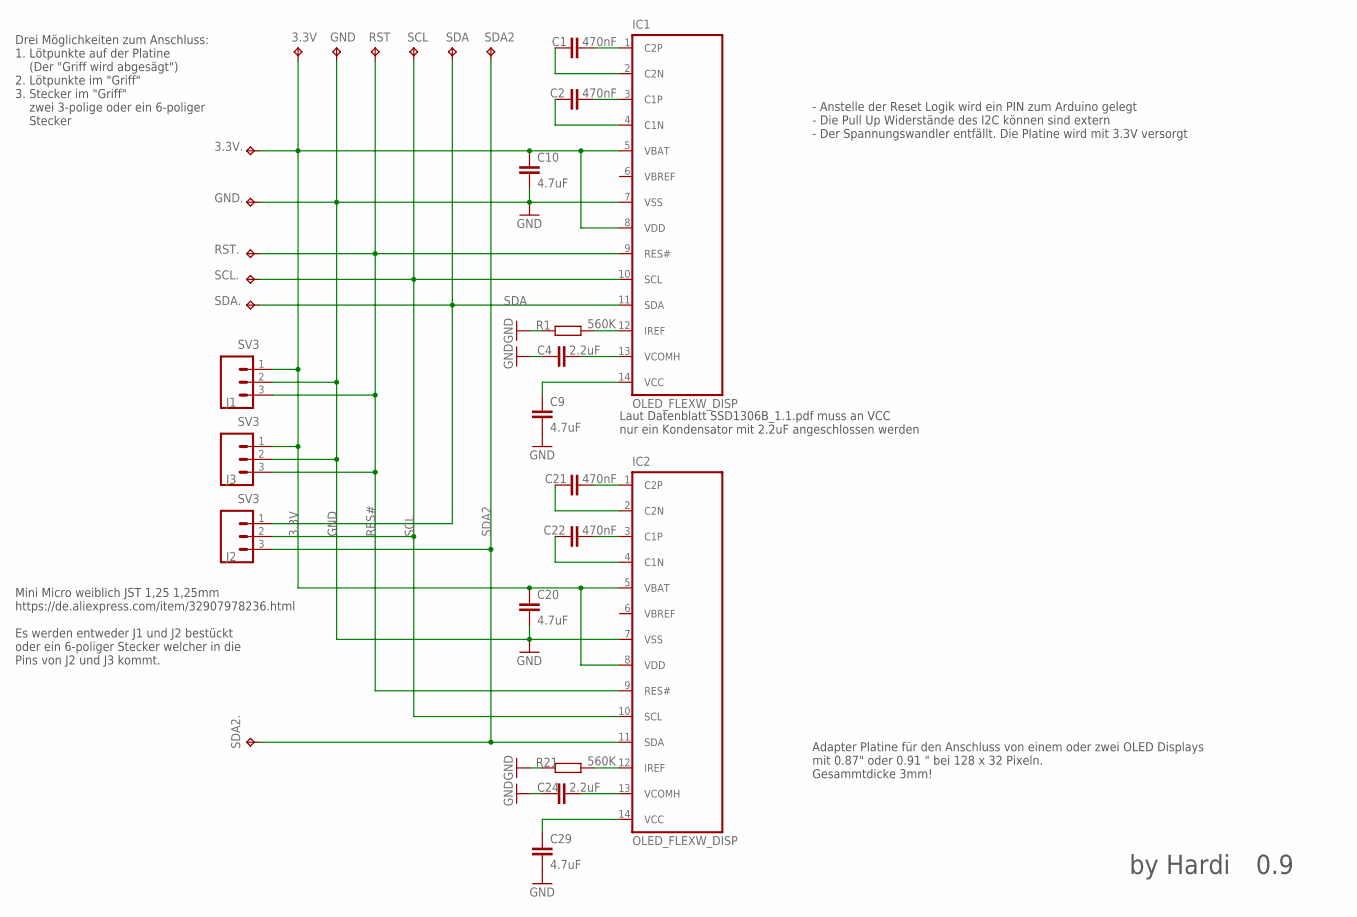
[picture p42: schematic OLED_Adapter.sch]

Parts:
3.3V: 3.3V; TP16SQ
3.3V.: TPTP16SQ; TP16SQ
C1, C2, C21, C22: 470nF; C0603
C4, C24: 2.2uF; C0603
C9, C10, C20, C29: 4.7uF; C0603
GND: GND; TP16R
GND.: TPTP16R; TP16R
IC1, IC2: OLED_FLEXW_DISP; OLED_FLEX_W_DISP
J1, J2, J3: SV3; MINI
R1, R21: 560K; R0603
RST: RST; TP16R
RST.: TPTP16R; TP16R
SCL: SCL; TP16R
SCL.: TPTP16R; TP16R
SDA: SDA; TP16R
SDA2: SDA2; TP16R
SDA2., SDA.: TPTP16R; TP16R

Connections:
3.3V: 3.3V.TP, 3.3V..TP, C10.1, C20.1, IC1.5 (VBAT), IC1.8 (VDD), IC2.5 (VBAT), IC2.8 (VDD), J1.1, J3.1
GND: C4.1, C9.2, C10.2, C20.2, C24.1, C29.2, GND.TP, GND..TP, IC1.7 (VSS), IC2.7 (VSS), J1.2, J3.2, R1.1, R21.1
unnamed: IC1.12 (IREF), R1.2
unnamed: C21.2, IC2.1 (C2P)
unnamed: C1.2, IC1.1 (C2P)
unnamed: C1.1, IC1.2 (C2N)
unnamed: C2.2, IC1.3 (C1P)
unnamed: C2.1, IC1.4 (C1N)
unnamed: C9.1, IC1.14 (VCC)
unnamed: C4.2, IC1.13 (VCOMH)
unnamed: C21.1, IC2.2 (C2N)
unnamed: C22.2, IC2.3 (C1P)
unnamed: C22.1, IC2.4 (C1N)
unnamed: IC2.12 (IREF), R21.2
unnamed: C29.1, IC2.14 (VCC)
unnamed: C24.2, IC2.13 (VCOMH)
RES#: IC1.9 (RES#), IC2.9 (RES#), J1.3, J3.3, RST.TP, RST..TP
SCL: IC1.10 (SCL), IC2.10 (SCL), J2.2, SCL.TP, SCL..TP
SDA: IC1.11 (SDA), J2.1, SDA.TP, SDA..TP
SDA2: IC2.11 (SDA), J2.3, SDA2.TP, SDA2..TP

Notes on the sheet:
Laut Datenblatt SSD1306B_1.1.pdf muss an VCC nur ein Kondensator mit 2.2uF angeschlossen werden
- Anstelle der Reset Logik wird ein PIN zum Arduino gelegt - Die Pull Up Widerstände des I2C können sind extern - Der Spannungswandler entfällt. Die Platine wird mit 3.3V versorgt
Adapter Platine für den Anschluss von einem oder zwei OLED Displays mit 0.87" oder 0.91 " bei 128 x 32 Pixeln. Gesammtdicke 3mm!
0.9
by Hardi
Mini Micro weiblich JST 1,25 1,25mm https://de.aliexpress.com/item/32907978236.html Es werden entweder J1 und J2 bestückt oder ein 6-poliger Stecker welcher in die Pins von J2 und J3 kommt.
Drei Möglichkeiten zum Anschluss: 1. Lötpunkte auf der Platine (Der "Griff wird abgesägt") 2. Lötpunkte im "Griff" 3. Stecker im "Griff" zwei 3-polige oder ein 6-poliger Stecker

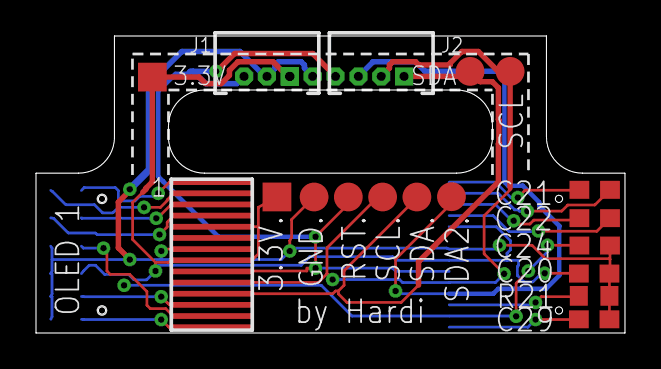
[picture p43: board OLED_Adapter.brd from above]

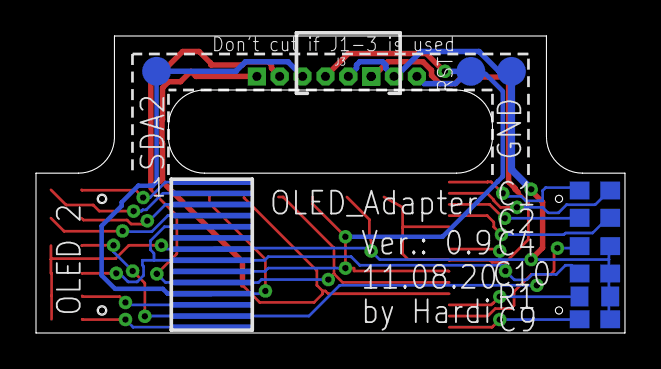
[picture p44: board OLED_Adapter.brd from below]

Board: 2 copper layers, 32.7 x 16.5 mm, 29 parts (11 on the bottom side), 20 nets.
