Hardi-St/Zugzielanzeiger_mit_Arduino/Platinen/Eigene OLED Platine/OLED_Adapter_15x.brd

## EAGLE design Platinen/Eigene OLED Platine/OLED_Adapter_15x.brd (2020-10-03)

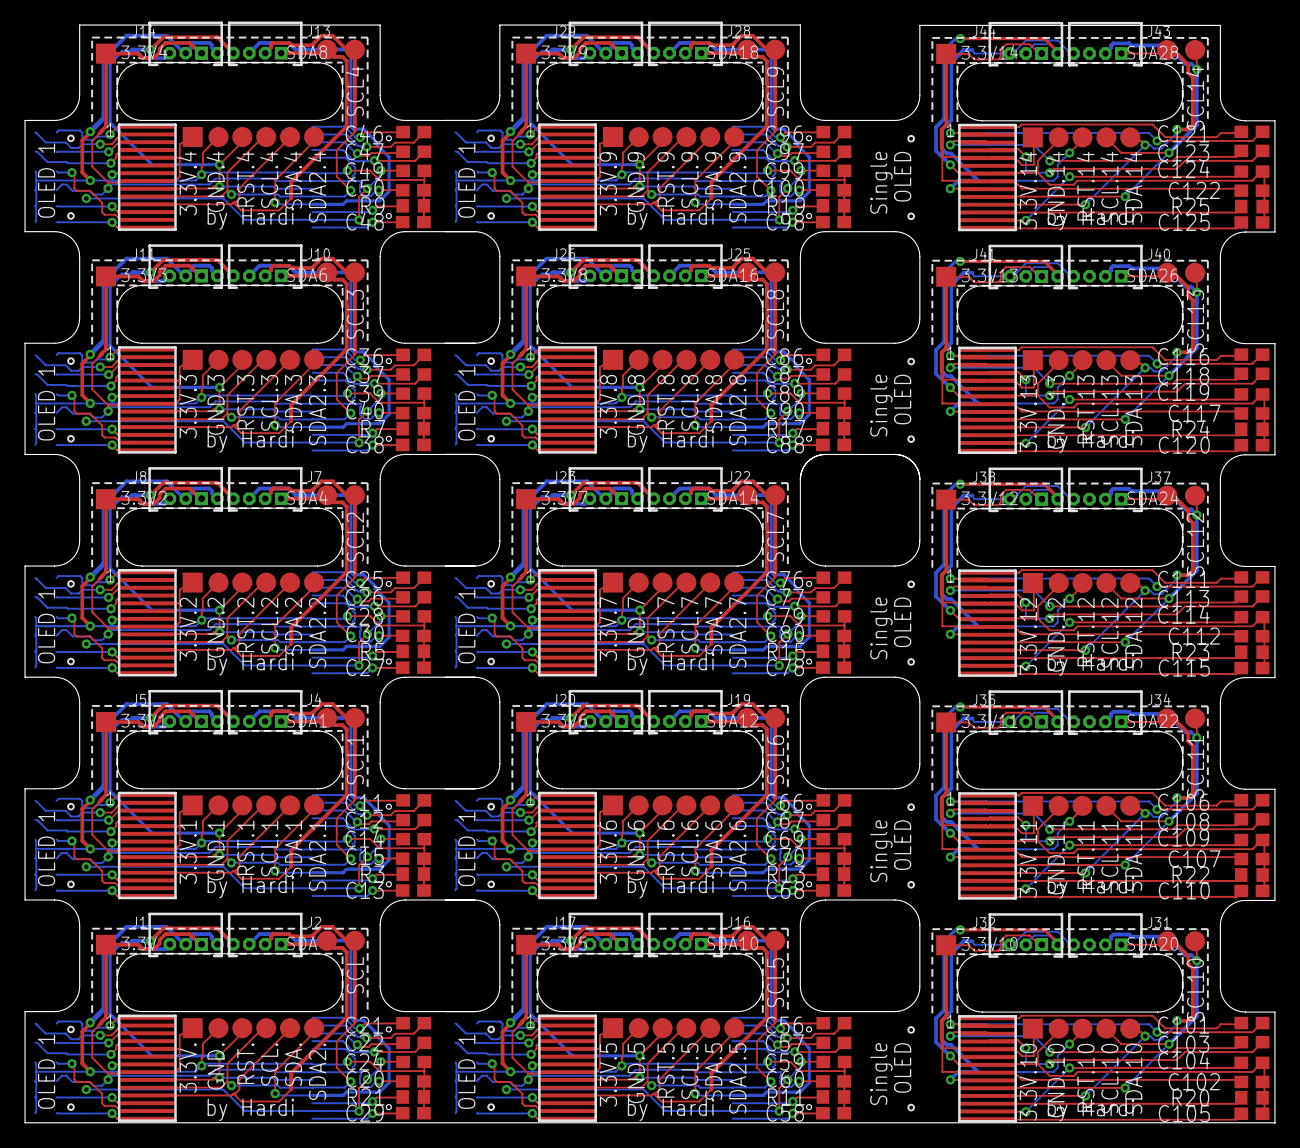
[picture p45: board OLED_Adapter_15x.brd from above]

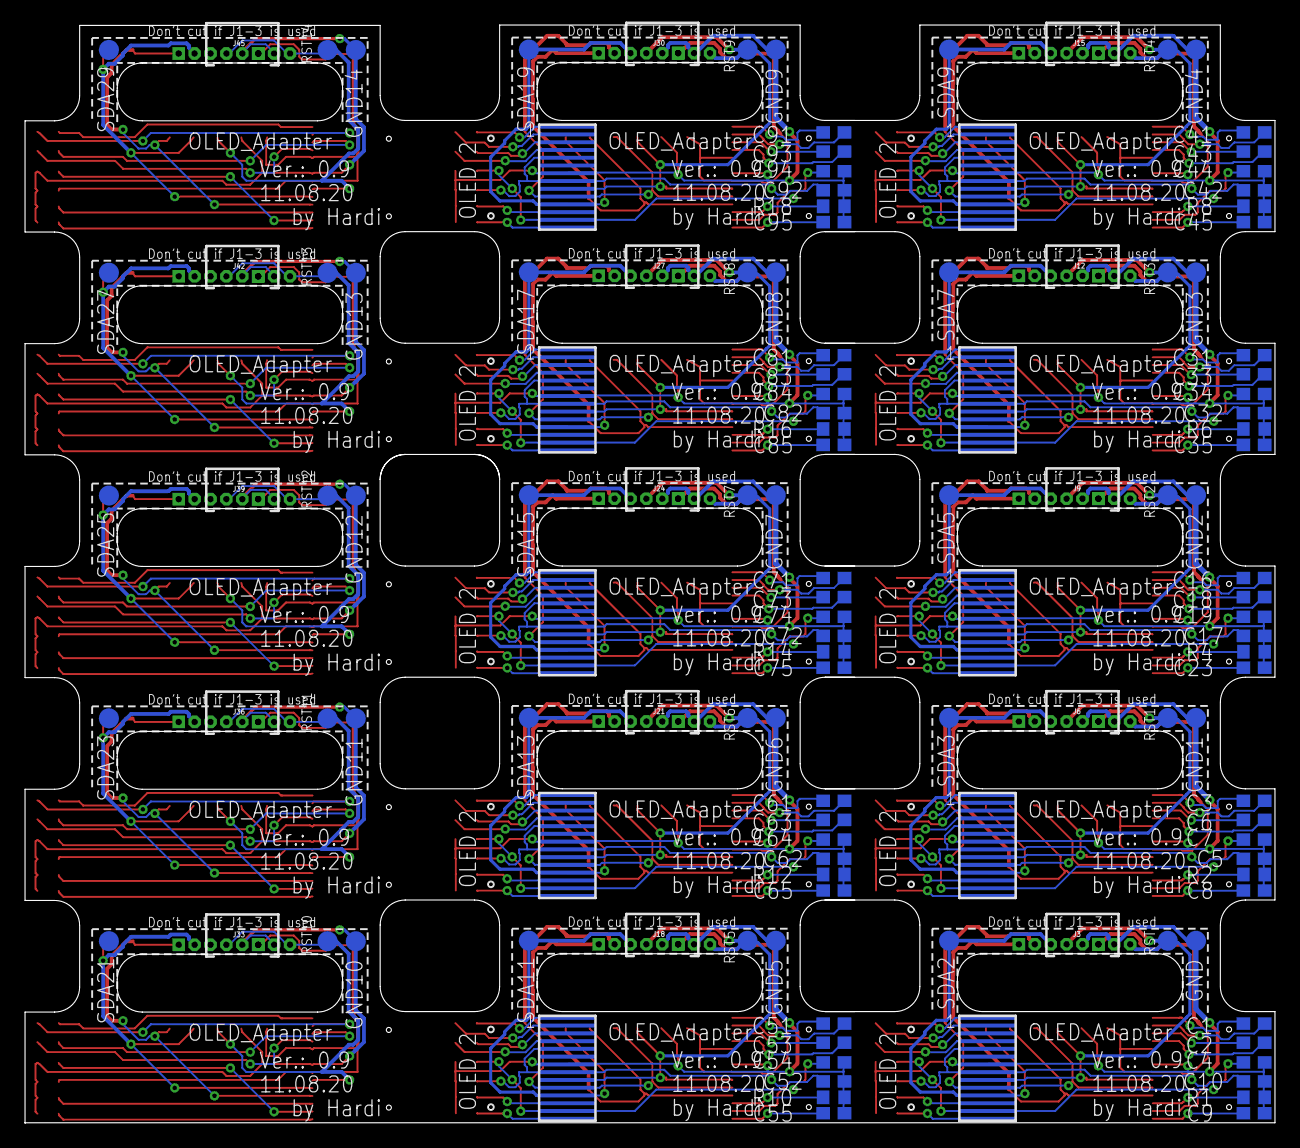
[picture p46: board OLED_Adapter_15x.brd from below]

Board: 2 copper layers, 99.8 x 87.7 mm, 395 parts (130 on the bottom side), 260 nets.

Parts:
3.3V, 3.3V1, 3.3V2, 3.3V3, 3.3V4, 3.3V5, 3.3V6, 3.3V7, 3.3V8, 3.3V9, 3.3V10, 3.3V11, 3.3V12, 3.3V13, 3.3V14: 3.3V; TP16SQ
3.3V., 3.3V.1, 3.3V.2, 3.3V.3, 3.3V.4, 3.3V.5, 3.3V.6, 3.3V.7, 3.3V.8, 3.3V.9, 3.3V.10, 3.3V.11, 3.3V.12, 3.3V.13, 3.3V.14: TPTP16SQ; TP16SQ
C1, C2, C3, C6, C11, C12, C16, C18, C21, C22, C25, C26, C31, C33, C36, C37, C41, C43, C46, C47, C51, C53, C56, C57, C61, C63, C66, C67, C71, C73, C76, C77, C81, C83, C86, C87, C91, C93, C96, C97, C101, C103, C106, C108, C111, C113, C116, C118, C121, C123: 470nF; C0603
C4, C7, C14, C19, C24, C28, C34, C39, C44, C49, C54, C59, C64, C69, C74, C79, C84, C89, C94, C99, C104, C109, C114, C119, C124: 2.2uF; C0603
C5, C8, C9, C10, C13, C15, C17, C20, C23, C27, C29, C30, C32, C35, C38, C40, C42, C45, C48, C50, C52, C55, C58, C60, C62, C65, C68, C70, C72, C75, C78, C80, C82, C85, C88, C90, C92, C95, C98, C100, C102, C105, C107, C110, C112, C115, C117, C120, C122, C125: 4.7uF; C0603
GND, GND1, GND2, GND3, GND4, GND5, GND6, GND7, GND8, GND9, GND10, GND11, GND12, GND13, GND14: GND; TP16R
GND., GND.1, GND.2, GND.3, GND.4, GND.5, GND.6, GND.7, GND.8, GND.9, GND.10, GND.11, GND.12, GND.13, GND.14: TPTP16R; TP16R
IC1, IC2, IC3, IC4, IC5, IC6, IC7, IC8, IC9, IC10, IC11, IC12, IC13, IC14, IC15, IC16, IC17, IC18, IC19, IC20, IC21, IC22, IC23, IC24, IC25: OLED_FLEXW_DISP; OLED_FLEX_W_DISP
J1, J2, J3, J4, J5, J6, J7, J8, J9, J10, J11, J12, J13, J14, J15, J16, J17, J18, J19, J20, J21, J22, J23, J24, J25, J26, J27, J28, J29, J30, J31, J32, J33, J34, J35, J36, J37, J38, J39, J40, J41, J42, J43, J44, J45: SV3; MINI
R1, R2, R3, R4, R5, R6, R7, R8, R9, R10, R11, R12, R13, R14, R15, R16, R17, R18, R19, R20, R21, R22, R23, R24, R25: 560K; R0603
RST, RST1, RST2, RST3, RST4, RST5, RST6, RST7, RST8, RST9, RST10, RST11, RST12, RST13, RST14: RST; TP16R
RST., RST.1, RST.2, RST.3, RST.4, RST.5, RST.6, RST.7, RST.8, RST.9, RST.10, RST.11, RST.12, RST.13, RST.14: TPTP16R; TP16R
SCL, SCL1, SCL2, SCL3, SCL4, SCL5, SCL6, SCL7, SCL8, SCL9, SCL10, SCL11, SCL12, SCL13, SCL14: SCL; TP16R
SCL., SCL.1, SCL.2, SCL.3, SCL.4, SCL.5, SCL.6, SCL.7, SCL.8, SCL.9, SCL.10, SCL.11, SCL.12, SCL.13, SCL.14: TPTP16R; TP16R
SDA, SDA1, SDA4, SDA6, SDA8, SDA10, SDA12, SDA14, SDA16, SDA18, SDA20, SDA22, SDA24, SDA26, SDA28: SDA; TP16R
SDA2, SDA3, SDA5, SDA7, SDA9, SDA11, SDA13, SDA15, SDA17, SDA19, SDA21, SDA23, SDA25, SDA27, SDA29: SDA2; TP16R
SDA2., SDA2.1, SDA2.2, SDA2.3, SDA2.4, SDA2.5, SDA2.6, SDA2.7, SDA2.8, SDA2.9, SDA., SDA.1, SDA.2, SDA.3, SDA.4, SDA.5, SDA.6, SDA.7, SDA.8, SDA.9, SDA.10, SDA.11, SDA.12, SDA.13, SDA.14: TPTP16R; TP16R

Connections:
3.3V: 3.3V.TP, 3.3V..TP, C10.1, C20.1, IC1.5, IC1.8, IC2.5, IC2.8, J1.1, J3.1
3.3V1: 3.3V1.TP, 3.3V.1.TP, C5.1, C15.1, IC3.5, IC3.8, IC4.5, IC4.8, J5.1, J6.1
3.3V2: 3.3V2.TP, 3.3V.2.TP, C17.1, C30.1, IC5.5, IC5.8, IC6.5, IC6.8, J8.1, J9.1
3.3V3: 3.3V3.TP, 3.3V.3.TP, C32.1, C40.1, IC7.5, IC7.8, IC8.5, IC8.8, J11.1, J12.1
3.3V4: 3.3V4.TP, 3.3V.4.TP, C42.1, C50.1, IC9.5, IC9.8, IC10.5, IC10.8, J14.1, J15.1
3.3V5: 3.3V5.TP, 3.3V.5.TP, C52.1, C60.1, IC11.5, IC11.8, IC12.5, IC12.8, J17.1, J18.1
3.3V6: 3.3V6.TP, 3.3V.6.TP, C62.1, C70.1, IC13.5, IC13.8, IC14.5, IC14.8, J20.1, J21.1
3.3V7: 3.3V7.TP, 3.3V.7.TP, C72.1, C80.1, IC15.5, IC15.8, IC16.5, IC16.8, J23.1, J24.1
3.3V8: 3.3V8.TP, 3.3V.8.TP, C82.1, C90.1, IC17.5, IC17.8, IC18.5, IC18.8, J26.1, J27.1
3.3V9: 3.3V9.TP, 3.3V.9.TP, C92.1, C100.1, IC19.5, IC19.8, IC20.5, IC20.8, J29.1, J30.1
3.3V10: 3.3V10.TP, 3.3V.10.TP, C102.1, IC21.5, IC21.8, J32.1, J33.1
3.3V11: 3.3V11.TP, 3.3V.11.TP, C107.1, IC22.5, IC22.8, J35.1, J36.1
3.3V12: 3.3V12.TP, 3.3V.12.TP, C112.1, IC23.5, IC23.8, J38.1, J39.1
3.3V13: 3.3V13.TP, 3.3V.13.TP, C117.1, IC24.5, IC24.8, J41.1, J42.1
3.3V14: 3.3V14.TP, 3.3V.14.TP, C122.1, IC25.5, IC25.8, J44.1, J45.1
GND: C4.1, C9.2, C10.2, C20.2, C24.1, C29.2, GND.TP, GND..TP, IC1.7, IC2.7, J1.2, J3.2, R1.1, R21.1
GND1: C5.2, C7.1, C8.2, C13.2, C14.1, C15.2, GND1.TP, GND.1.TP, IC3.7, IC4.7, J5.2, J6.2, R2.1, R3.1
GND2: C17.2, C19.1, C23.2, C27.2, C28.1, C30.2, GND2.TP, GND.2.TP, IC5.7, IC6.7, J8.2, J9.2, R4.1, R5.1
GND3: C32.2, C34.1, C35.2, C38.2, C39.1, C40.2, GND3.TP, GND.3.TP, IC7.7, IC8.7, J11.2, J12.2, R6.1, R7.1
GND4: C42.2, C44.1, C45.2, C48.2, C49.1, C50.2, GND4.TP, GND.4.TP, IC9.7, IC10.7, J14.2, J15.2, R8.1, R9.1
GND5: C52.2, C54.1, C55.2, C58.2, C59.1, C60.2, GND5.TP, GND.5.TP, IC11.7, IC12.7, J17.2, J18.2, R10.1, R11.1
GND6: C62.2, C64.1, C65.2, C68.2, C69.1, C70.2, GND6.TP, GND.6.TP, IC13.7, IC14.7, J20.2, J21.2, R12.1, R13.1
GND7: C72.2, C74.1, C75.2, C78.2, C79.1, C80.2, GND7.TP, GND.7.TP, IC15.7, IC16.7, J23.2, J24.2, R14.1, R15.1
GND8: C82.2, C84.1, C85.2, C88.2, C89.1, C90.2, GND8.TP, GND.8.TP, IC17.7, IC18.7, J26.2, J27.2, R16.1, R17.1
GND9: C92.2, C94.1, C95.2, C98.2, C99.1, C100.2, GND9.TP, GND.9.TP, IC19.7, IC20.7, J29.2, J30.2, R18.1, R19.1
GND10: C102.2, C104.1, C105.2, GND10.TP, GND.10.TP, IC21.7, J32.2, J33.2, R20.1
GND11: C107.2, C109.1, C110.2, GND11.TP, GND.11.TP, IC22.7, J35.2, J36.2, R22.1
GND12: C112.2, C114.1, C115.2, GND12.TP, GND.12.TP, IC23.7, J38.2, J39.2, R23.1
GND13: C117.2, C119.1, C120.2, GND13.TP, GND.13.TP, IC24.7, J41.2, J42.2, R24.1
GND14: C122.2, C124.1, C125.2, GND14.TP, GND.14.TP, IC25.7, J44.2, J45.2, R25.1
unnamed: IC1.12, R1.2
unnamed: C21.2, IC2.1
unnamed: C1.2, IC1.1
unnamed: C1.1, IC1.2
unnamed: C2.2, IC1.3
unnamed: C2.1, IC1.4
unnamed: C9.1, IC1.14
unnamed: C4.2, IC1.13
unnamed: C21.1, IC2.2
unnamed: C22.2, IC2.3
unnamed: C22.1, IC2.4
unnamed: IC2.12, R21.2
unnamed: C29.1, IC2.14
unnamed: C24.2, IC2.13
unnamed: C3.2, IC3.1
unnamed: C3.1, IC3.2
unnamed: C6.2, IC3.3
unnamed: C6.1, IC3.4
unnamed: IC3.12, R2.2
unnamed: C8.1, IC3.14
unnamed: C7.2, IC3.13
unnamed: C11.2, IC4.1
unnamed: C11.1, IC4.2
unnamed: C12.2, IC4.3
unnamed: C12.1, IC4.4
unnamed: IC4.12, R3.2
unnamed: C13.1, IC4.14
unnamed: C14.2, IC4.13
unnamed: C16.2, IC5.1
unnamed: C16.1, IC5.2
unnamed: C18.2, IC5.3
unnamed: C18.1, IC5.4
unnamed: IC5.12, R4.2
unnamed: C23.1, IC5.14
unnamed: C19.2, IC5.13
unnamed: C25.2, IC6.1
unnamed: C25.1, IC6.2
unnamed: C26.2, IC6.3
unnamed: C26.1, IC6.4
unnamed: IC6.12, R5.2
unnamed: C27.1, IC6.14
unnamed: C28.2, IC6.13
unnamed: C31.2, IC7.1
unnamed: C31.1, IC7.2
unnamed: C33.2, IC7.3
unnamed: C33.1, IC7.4
unnamed: IC7.12, R6.2
unnamed: C35.1, IC7.14
unnamed: C34.2, IC7.13
unnamed: C36.2, IC8.1
unnamed: C36.1, IC8.2
unnamed: C37.2, IC8.3
unnamed: C37.1, IC8.4
unnamed: IC8.12, R7.2
unnamed: C38.1, IC8.14
unnamed: C39.2, IC8.13
unnamed: C41.2, IC9.1
unnamed: C41.1, IC9.2
unnamed: C43.2, IC9.3
unnamed: C43.1, IC9.4
unnamed: IC9.12, R8.2
unnamed: C45.1, IC9.14
unnamed: C44.2, IC9.13
unnamed: C46.2, IC10.1
unnamed: C46.1, IC10.2
unnamed: C47.2, IC10.3
unnamed: C47.1, IC10.4
unnamed: IC10.12, R9.2
unnamed: C48.1, IC10.14
unnamed: C49.2, IC10.13
unnamed: C51.2, IC11.1
unnamed: C51.1, IC11.2
unnamed: C53.2, IC11.3
unnamed: C53.1, IC11.4
unnamed: IC11.12, R10.2
unnamed: C55.1, IC11.14
unnamed: C54.2, IC11.13
unnamed: C56.2, IC12.1
unnamed: C56.1, IC12.2
unnamed: C57.2, IC12.3
unnamed: C57.1, IC12.4
unnamed: IC12.12, R11.2
unnamed: C58.1, IC12.14
unnamed: C59.2, IC12.13
unnamed: C61.2, IC13.1
unnamed: C61.1, IC13.2
unnamed: C63.2, IC13.3
unnamed: C63.1, IC13.4
unnamed: IC13.12, R12.2
unnamed: C65.1, IC13.14
unnamed: C64.2, IC13.13
unnamed: C66.2, IC14.1
unnamed: C66.1, IC14.2
unnamed: C67.2, IC14.3
unnamed: C67.1, IC14.4
unnamed: IC14.12, R13.2
unnamed: C68.1, IC14.14
unnamed: C69.2, IC14.13
unnamed: C71.2, IC15.1
unnamed: C71.1, IC15.2
unnamed: C73.2, IC15.3
unnamed: C73.1, IC15.4
unnamed: IC15.12, R14.2
unnamed: C75.1, IC15.14
unnamed: C74.2, IC15.13
unnamed: C76.2, IC16.1
unnamed: C76.1, IC16.2
unnamed: C77.2, IC16.3
unnamed: C77.1, IC16.4
unnamed: IC16.12, R15.2
unnamed: C78.1, IC16.14
unnamed: C79.2, IC16.13
unnamed: C81.2, IC17.1
unnamed: C81.1, IC17.2
unnamed: C83.2, IC17.3
unnamed: C83.1, IC17.4
unnamed: IC17.12, R16.2
unnamed: C85.1, IC17.14
unnamed: C84.2, IC17.13
unnamed: C86.2, IC18.1
unnamed: C86.1, IC18.2
unnamed: C87.2, IC18.3
unnamed: C87.1, IC18.4
unnamed: IC18.12, R17.2
unnamed: C88.1, IC18.14
unnamed: C89.2, IC18.13
unnamed: C91.2, IC19.1
unnamed: C91.1, IC19.2
unnamed: C93.2, IC19.3
unnamed: C93.1, IC19.4
unnamed: IC19.12, R18.2
unnamed: C95.1, IC19.14
unnamed: C94.2, IC19.13
unnamed: C96.2, IC20.1
unnamed: C96.1, IC20.2
unnamed: C97.2, IC20.3
unnamed: C97.1, IC20.4
unnamed: IC20.12, R19.2
unnamed: C98.1, IC20.14
unnamed: C99.2, IC20.13
unnamed: C101.2, IC21.1
unnamed: C101.1, IC21.2
unnamed: C103.2, IC21.3
unnamed: C103.1, IC21.4
unnamed: IC21.12, R20.2
unnamed: C105.1, IC21.14
unnamed: C104.2, IC21.13
unnamed: C106.2, IC22.1
unnamed: C106.1, IC22.2
unnamed: C108.2, IC22.3
unnamed: C108.1, IC22.4
unnamed: IC22.12, R22.2
unnamed: C110.1, IC22.14
unnamed: C109.2, IC22.13
unnamed: C111.2, IC23.1
unnamed: C111.1, IC23.2
unnamed: C113.2, IC23.3
unnamed: C113.1, IC23.4
unnamed: IC23.12, R23.2
unnamed: C115.1, IC23.14
unnamed: C114.2, IC23.13
unnamed: C116.2, IC24.1
unnamed: C116.1, IC24.2
unnamed: C118.2, IC24.3
unnamed: C118.1, IC24.4
unnamed: IC24.12, R24.2
unnamed: C120.1, IC24.14
unnamed: C119.2, IC24.13
unnamed: C121.2, IC25.1
unnamed: C121.1, IC25.2
unnamed: C123.2, IC25.3
unnamed: C123.1, IC25.4
unnamed: IC25.12, R25.2
unnamed: C125.1, IC25.14
unnamed: C124.2, IC25.13
RES#: IC1.9, IC2.9, J1.3, J3.3, RST.TP, RST..TP
RES#1: IC3.9, IC4.9, J5.3, J6.3, RST1.TP, RST.1.TP
RES#2: IC5.9, IC6.9, J8.3, J9.3, RST2.TP, RST.2.TP
RES#3: IC7.9, IC8.9, J11.3, J12.3, RST3.TP, RST.3.TP
RES#4: IC9.9, IC10.9, J14.3, J15.3, RST4.TP, RST.4.TP
RES#5: IC11.9, IC12.9, J17.3, J18.3, RST5.TP, RST.5.TP
RES#6: IC13.9, IC14.9, J20.3, J21.3, RST6.TP, RST.6.TP
RES#7: IC15.9, IC16.9, J23.3, J24.3, RST7.TP, RST.7.TP
RES#8: IC17.9, IC18.9, J26.3, J27.3, RST8.TP, RST.8.TP
RES#9: IC19.9, IC20.9, J29.3, J30.3, RST9.TP, RST.9.TP
RES#10: IC21.9, J32.3, J33.3, RST10.TP, RST.10.TP
RES#11: IC22.9, J35.3, J36.3, RST11.TP, RST.11.TP
RES#12: IC23.9, J38.3, J39.3, RST12.TP, RST.12.TP
RES#13: IC24.9, J41.3, J42.3, RST13.TP, RST.13.TP
RES#14: IC25.9, J44.3, J45.3, RST14.TP, RST.14.TP
SCL: IC1.10, IC2.10, J2.2, SCL.TP, SCL..TP
SCL1: IC3.10, IC4.10, J4.2, SCL1.TP, SCL.1.TP
SCL2: IC5.10, IC6.10, J7.2, SCL2.TP, SCL.2.TP
SCL3: IC7.10, IC8.10, J10.2, SCL3.TP, SCL.3.TP
SCL4: IC9.10, IC10.10, J13.2, SCL4.TP, SCL.4.TP
SCL5: IC11.10, IC12.10, J16.2, SCL5.TP, SCL.5.TP
SCL6: IC13.10, IC14.10, J19.2, SCL6.TP, SCL.6.TP
SCL7: IC15.10, IC16.10, J22.2, SCL7.TP, SCL.7.TP
SCL8: IC17.10, IC18.10, J25.2, SCL8.TP, SCL.8.TP
SCL9: IC19.10, IC20.10, J28.2, SCL9.TP, SCL.9.TP
SCL10: IC21.10, J31.2, SCL10.TP, SCL.10.TP
SCL11: IC22.10, J34.2, SCL11.TP, SCL.11.TP
SCL12: IC23.10, J37.2, SCL12.TP, SCL.12.TP
SCL13: IC24.10, J40.2, SCL13.TP, SCL.13.TP
SCL14: IC25.10, J43.2, SCL14.TP, SCL.14.TP
SDA: IC1.11, J2.1, SDA.TP, SDA..TP
SDA1: IC3.11, J4.1, SDA1.TP, SDA.1.TP
SDA2: IC2.11, J2.3, SDA2.TP, SDA2..TP
SDA3: IC4.11, J4.3, SDA2.1.TP, SDA3.TP
SDA4: IC5.11, J7.1, SDA4.TP, SDA.2.TP
SDA5: IC6.11, J7.3, SDA2.2.TP, SDA5.TP
SDA6: IC7.11, J10.1, SDA6.TP, SDA.3.TP
SDA7: IC8.11, J10.3, SDA2.3.TP, SDA7.TP
SDA8: IC9.11, J13.1, SDA8.TP, SDA.4.TP
SDA9: IC10.11, J13.3, SDA2.4.TP, SDA9.TP
SDA10: IC11.11, J16.1, SDA10.TP, SDA.5.TP
SDA11: IC12.11, J16.3, SDA2.5.TP, SDA11.TP
SDA12: IC13.11, J19.1, SDA12.TP, SDA.6.TP
SDA13: IC14.11, J19.3, SDA2.6.TP, SDA13.TP
SDA14: IC15.11, J22.1, SDA14.TP, SDA.7.TP
SDA15: IC16.11, J22.3, SDA2.7.TP, SDA15.TP
SDA16: IC17.11, J25.1, SDA16.TP, SDA.8.TP
SDA17: IC18.11, J25.3, SDA2.8.TP, SDA17.TP
SDA18: IC19.11, J28.1, SDA18.TP, SDA.9.TP
SDA19: IC20.11, J28.3, SDA2.9.TP, SDA19.TP
SDA20: IC21.11, J31.1, SDA20.TP, SDA.10.TP
SDA21: IC22.11, J34.1, SDA22.TP, SDA.11.TP
SDA22: IC23.11, J37.1, SDA24.TP, SDA.12.TP
SDA23: IC24.11, J40.1, SDA26.TP, SDA.13.TP
SDA24: IC25.11, J43.1, SDA28.TP, SDA.14.TP
