Hardi-St/Zugzielanzeiger_mit_Arduino/Src/Beta/Bahnsteiganzeige_Hardi/tpssb_tf.h

/*
  Fontname: -FreeType-Teachers Pet Sans Serif Bold-Medium-R-Normal--8-80-72-72-P-61-ISO10646-1
  Copyright: (c) www.orgdot.com
  Glyphs: 176/178
  BBX Build Mode: 0
*/
const uint8_t u8g2_font_tpssb_tf[2101] U8G2_FONT_SECTION("u8g2_font_tpssb_tf") = 
  "\260\0\3\3\4\4\2\5\5\13\21\0\374\11\374\11\0\1n\2\320\10\30 \5\0B\12!\10\222C"
  "\212C\211\0\42\10%\337\13\11E\0#\13U\303\233\224JJ%\5\0$\22\227\303\234J($\12"
  "\26C\261\220($J\251\0%\20\230C\15\231D$\226\212U\305\42\211L\0&\21\231\303\235\232\222"
  "LVS\222\211d\42\31\251\4'\6\42_\12\2(\13\225\303;\221\232h\246\250\0)\14\225\303\13"
  "\241\232l$\23\251\1*\14u\307\253\224\224Yl\222)\4+\13fG,\241\350P\22\212\0,\7"
  "#\277\32\12\0-\7%\317\213\303\0.\6\22C\12\1/\15\226CL\231P&T\23\312\204\0\60"
  "\13\226\302\33\212\210\237$\24\0\61\12\226\302+\331\210\250'\3\62\13\226\302\33\212\210$\224\351h\63"
  "\17\226\302\33\212H(\232\12\205$\11\5\0\64\12\226\302K\22\351\20\324\3\65\16\226\302\213CPX"
  "\25\12I\22\12\0\66\15\226\302\33\212\210X\21q\222P\0\67\12\226\302\13\243L\243n\0\70\16\226"
  "\302\33\212\210$\241\210\70I(\0\71\16\226\302\33\212\210IR\24\222$\24\0:\7BC\12\241\0"
  ";\10S\277\32\71\200\2<\10\226CL\231\256:=\10VG\214C\371P>\11\226C\14\251n:"
  "\2\77\16\226C\34\212H(S\224\303\204\42\0@\26\212C.[\70\42\22QB\21J(\22\21I"
  "bq@\350\2A\13\226\302\33\212\210t\30\361$B\14\226\302\213\212\210t\21q\272\0C\14\226\302"
  "\33\212\210\250'\11\5\0D\12\226\302\213\212\210\237.\0E\13\226\302\213CPX\21j\64F\13\226"
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
  "\221P\242\77\355\11\303B\32\242D\177\1\356\13\304\302\32I(*\322_\0\357\13\266\302\13\221\34\42"
  "\324\237\0\360\13\226\302K\21Qr\342$)\361\15\226\302\213I\312\34P\231\220\70\11\362\15\226\302\33"
  "\251\34D\21q\222P\0\363\14\226\302;u\20E\304IB\1\364\16\226\302+Y(\16\241\210\70I"
  "(\0\365\16\226\302\213I\312\34B\21q\222P\0\366\15\206\302\13\221\34@\21q\222P\0\367\13f"
  "\306+\71\344P\207\210\0\370\14f\302\33\212\244b\251H(\0\371\14\226\302\33\251\34\42\342IB\1"
  "\372\14\226\302;u\210\210'\11\5\0\373\15\226\302+Y(\16\20\361$\241\0\374\13\206\302\13\221X"
  "\304\223\204\2\375\17\326\262;u\210\210'IQH\222P\0\376\13f\302\13aEt\21\12\1\377\17"
  "\306\262\13\221X\304\223\244($I(\0\0\0\0\4\377\377\0";
