Hardi-St/Zugzielanzeiger_mit_Arduino/Src/Beta/Bahnsteiganzeige_Hardi/6x13B_t_german.h

/*
  Fontname: -Misc-Fixed-Bold-R-SemiCondensed--13-120-75-75-C-60-ISO10646-1
  Copyright: Public domain font.  Share and enjoy.
  Glyphs: 103/1282
  BBX Build Mode: 0
*/
const uint8_t u8g2_font_6x13B_t_german[1173] U8G2_FONT_SECTION("u8g2_font_6x13B_t_german") = 
  "g\0\3\3\3\4\3\5\4\6\15\0\376\11\376\12\377\1e\2\300\4x \5\0n\7!\7JC"
  "\307\223\0\42\10\35Z\207\204E\0#\14>F\17\211b\241XH\24\0$\13>F\227\214Bc\241"
  "\211\0%\17NB\217\344\20!\312\24)\207\210\4\0&\14>B\217\214D\223\35\42\242\2'\6\32"
  "[\207\1(\14\334>\227D$\21\351&\222\11)\15\334>\207L$\23\351\42\222\210\0*\13.J"
  "\207HB\261PD\2+\12.J\227Pd\22\212\0,\10\234>\317D\11\0-\6\16R\207\1."
  "\10\234>\217\204\42\1/\14NB\247\232P\246(\23\12\1\60\14NB\227\214\42\342IB\23\1\61"
  "\12NB\227lD\324\223\1\62\13NB\17ED\22\312t\64\63\15NB\207Q\246F\25\222$\24"
  "\0\64\16NB\237P\66\42E\264\330\204\22\0\65\16NB\307!(\254L\204B\222\204\2\66\16N"
  "B\327H&\24V&$\222\204\2\67\15NB\207Q&\224\11eB\65\0\70\16NB\17E\304$"
  "\241\210\230$\24\0\71\15NB\17E\304\62)\252\211F\0:\14\304B\217\204\42\207I(\22\0;"
  "\13\304>\217\204\42\207M\224\0<\10NB\247LW\35=\7&J\207\35j>\11NB\207T\67"
  "\35\1\77\16NB\17ED\22\312\24\345\60\21\0@\14NB\17E\304r\70X\244\5A\14NB"
  "\227\214\42b:\214\230\4B\15NBGI\242\27\222D\227\13\0C\13NB\17ED\324\223\204\2"
  "D\13NBGI\242\377\313\5\0E\13NB\307!\250X\21*\32F\13NB\307!\250X\21j"
  "\4G\15NB\17ED\324R\42I(\0H\13NB\207\210\323a\304I\0I\11\314B\7E\244"
  "/\4J\13NB\27Q\217$\11\5\0K\16NB\207\210EB\232\221$J$\1L\10NB\207"
  "P\77\32M\13NB\207\210tx\10q\22N\15NB\207\250R\71\34$M$\1O\13NB\17"
  "E\304O\22\12\0P\13NBGE\304t\21j\4Q\13V>\17E\304\247C\204*R\15NB"
  "GE\304t!I\224H\2S\16NB\17ED\224R\205$\11\5\0T\11NB\207I\250\237\0"
  "U\12NB\207\210\77I(\0V\14NB\207\210\223\204\304&\24\1W\12NB\207\210\323\341\223\0"
  "X\16NB\207\210$!\321d$\212\210$Y\14NB\207\210$!\321\204:\1Z\14NB\207Q"
  "&\224)\312\204\6[\10\334>\207I\177\42\134\14NB\207P*\224*J\205\2]\10\334>\7I"
  "\177\62^\10\36Z\227\214\42\22_\6\16>\207\1`\7\223b\207H\0a\12\66B\17Ur\242L"
  "\24b\16NB\207P\213dB\42U(\22\0c\13\66B\17EDT\222P\0d\13NB\247\26"
  "\11\245\304\62Qe\13\66B\17Et\30J)\0f\14NB\327H\242(+\11\265\1g\15F:"
  "\317E\323HJ\21I(\0h\13NB\207P\213dB\342$i\12\314B\217H:\322\205\0j\15"
  "]:\237:`\246\215B\221L\0k\15NB\207P\213\204\64#I\224\4l\10\314B\307H\277\20"
  "m\11\66BG\345\360P\22n\12\66B\207D\62!q\22o\12\66B\17E\304IB\1p\15F"
  ":\207D\62!U(\212\212\0q\13F:\217\204R\242L\24\65r\12\66B\207D\62!j\4s"
  "\15\66B\17E$\231JD\22\12\0t\14FB\217PV\22j\21M\0u\11\66B\207\210\227\211"
  "\2v\13\66B\207\210IB\242\211\0w\14\66B\207\210t\70XB\21\0x\14\66B\207HB\23"
  "\312(\42\1y\14F:\207\210\313D\221$\241\0z\10\66B\207MG\3{\15]>\327D\246("
  "\31\212d\212\3|\7JC\307\3\1}\16]>\307P\246$\234\10e*#\0~\10\35Z\217\344"
  "\24\1\276\21VB\307,\42\223\212\42\22\212l$\11\21\5\304\17VB\207\210$\207\310(\42\322a"
  "D\22\326\16VB\207\210$\7PD<I(\0\334\13VB\217\316\42>I(\0\337\15N>\17"
  "ED\272\210\230.Q\0\344\14NB\217\356\0\252\344D\231(\366\16NB\207\210$\7PD\234$"
  "\24\0\374\13NB\207\210$\26\361\62Q\0\0\0\4\377\377\0";
