Hardi-St/Zugzielanzeiger_mit_Arduino/Src/Beta/Bahnsteiganzeige_Hardi/tpss_t_german.h

/*
  Fontname: -FreeType-Teachers Pet Sans Serif-Medium-R-Normal--8-80-72-72-P-18-ISO10646-1
  Copyright: (c) www.orgdot.com
  Glyphs: 102/633
  BBX Build Mode: 0
*/
const uint8_t u8g2_font_tpss_t_german[1122] U8G2_FONT_SECTION("u8g2_font_tpss_t_german") = 
  "f\0\3\2\4\4\2\5\5\12\20\0\374\11\374\11\0\1X\2\257\4E \5\0B\12!\7\221\303"
  "\211\213\0\42\7#\337\212D\11#\13U\303\233\312\240T\6\245\2$\20\225\303\233\245\242d[\22%"
  "J\242T\26\0%\15\225\303\213L\12\263\260\26FZ\0&\21\227\303\234\255\224e[)\213\262(K"
  "\222%\1'\6!\337\11\1(\14\225\303;)\13\263\64LS\1)\14\225\303\13\265\230fa\26i"
  "\0*\13u\307\253Je\313\226\246\10+\12U\307\253\60\32\244\60\2,\6\42\77\32\5-\6\25\317"
  "\213A.\6\21\303\211\0/\14\225\303\313,\314\302Z\230\205\0\60\12\225B\233%\363[\262\0\61\13"
  "\225B\253LJ\302\236\6\1\62\13\225B\233%\323\302\254\343 \63\15\225B\233%\13#\65\14\265d"
  "\1\64\11\225BKM\33\306\36\65\14\225B\213c\70\210E-Y\0\66\15\225B\233%\23\207$s"
  "K\26\0\67\12\225B\213A\314\32\273\1\70\15\225B\233%\323\222%sK\26\0\71\15\225B\233%"
  "\263%C\30j\311\2:\6A\303\211(;\7R\77\232T\1<\10\225\303\313\254k\7=\10\65\313"
  "\213A\35\4>\11\225\303\213\264[G\0\77\15\225\303\233%\13\263b\16\205\21\0@\25\211\303\235a"
  "\212\223HJJISRR\242\34H\206!\1A\13\225B\233%\323\206!\363\26B\15\225B\213!"
  "\311\264A\311\334\6\5C\13\225B\233%\23{K\26\0D\13\225B\213!\311\374\66(\0E\13\225"
  "B\213c\70$a\343 F\13\225B\213c\70$aG\0G\15\225B\233%\23\223!sK\26\0"
  "H\13\225B\213\314\66\14\231\267\0I\6\221B\211\7J\11\225B\313>j\311\2K\16\225B\213\314"
  "\224\224\264$\252dZ\0L\11\225B\213\260\37\7\1M\14\227B\214t[*R\244z\15N\13\225"
  "B\213lR\22i\363\26O\12\225B\233%\363[\262\0P\14\225B\213!\311\264A\11;\2Q\15"
  "\225B\233%\363\222(\211RY\0R\14\225B\213!\311\264A\311\274\5S\14\225B\233%S\327P"
  "\323\222\5T\11\225B\213A\12\373\11U\11\225B\213\314\337\222\5V\17\225B\213\314\226\224\222(\211"
  "\222,\214\0W\21\227B\214\324\232\64%\245\244\226\204I\230D\0X\15\225B\213LKja\226\324"
  "l\1Y\13\225B\213LKjaO\0Z\13\225B\213A\254u\14\7\1[\11\223\303\212!\352\323"
  "\0\134\12u\303\213\64L\213i\0]\11\223\303\212\251OC\0^\6#\353\232\6_\6\26C\214\3"
  "`\6\42k\32\5a\12eB\233%sK\206\0b\14\225B\213\260\70$\231[\262\0c\12eB"
  "\233%\23k\311\2d\13\225B\313\226AsK\206\0e\14eB\233%\33\206\60K\26\0f\13\225"
  "B+\251\222ma\67\0g\15\245\62\233%sK\206\60\324\222\5h\12\225B\213\260\305\244\271\5i"
  "\7\221B\11e\30j\12\322\262\231Z\322/\12\0k\15\225B\213\260))iIT\311\2l\6\221"
  "B\211\7m\16gB\214D\31\22S$ER$\25n\11eB\213\304\244\271\5o\12eB\233%"
  "sK\26\0p\13\245\62\233%s\33\224\260\21q\22\246\262\233!\311\222,\311\222,\32\322pL\23"
  "\0r\12d\302\212d\210\262\66\0s\12eB\233%]\265d\1t\13\224\302\232\254\64$Y'\0"
  "u\11eB\213\314[\262\0v\14eB\213LKJI\26F\0w\16gB\214TM\232\222Z\22"
  "&\21\0x\13eB\213,\251\205YR\13y\15\245\62\213\314[\62\204\241\226,\0z\11eB\233"
  "A\353\66\10{\14\226CL-L\63\71\215c\1|\6\221\303\211\7}\14\226C\14\271\32ki\230"
  "\211\0~\7%j\213E\31\304\15\265B\233:\260d\332\60d\336\2\326\14\265B\233:\260d~K"
  "\26\0\334\12\265B\233r\346o\311\2\337\16\265:\213!\311\24%sQ\302F\0\344\13\205B\233:"
  "\260dn\311\20\366\13\205B\233:\260dn\311\2\374\12\205B\233r\346-Y\0\0\0\0\4\377\377"
  "\0";
