Hardi-St/Zugzielanzeiger_mit_Arduino/Src/Beta/Bahnsteiganzeige_Hardi/4x6_t_german.h

/*
  Fontname: -Misc-Fixed-Medium-R-Normal--6-60-75-75-C-40-ISO10646-1
  Copyright: Public domain font.  Share and enjoy.
  Glyphs: 102/919
  BBX Build Mode: 0
*/
const uint8_t u8g2_font_4x6_t_german[792] U8G2_FONT_SECTION("u8g2_font_4x6_t_german") = 
  "f\0\2\2\3\3\2\4\4\4\6\0\377\5\377\5\377\0\356\1\334\2\373 \5\200\315\0!\6\351\310"
  "\254\0\42\6\223\313$\25#\12\254\310\244\64T\32*\1$\11\263\307\245\241\301H\11%\10\253\310d"
  "\324F\1&\11\254\310\305\24\253\230\2'\5\321\313\10(\7\362\307\251f\0)\10\262\307\304T)\0"
  "*\7\253\310\244j\65+\10\253\310\305\264b\2,\6\222\307)\0-\5\213\312\14.\5\311\310\4/"
  "\7\253\310Ve\4\60\10\253\310UCU\0\61\7\253\310%Y\15\62\7\253\310\65S\32\63\10\253\310"
  "\314\224\301\2\64\10\253\310$\65b\1\65\10\253\310\214\250\301\2\66\7\253\310M\325\2\67\10\253\310\314"
  "TF\0\70\7\253\310\255\326\2\71\7\253\310\265\344\2:\6\341\310\304\0;\7\252\307e\250\0<\10"
  "\253\310\246\32d\20=\6\233\311l\60>\11\253\310d\220A*\1\77\11\253\310h\220\62L\0@\7"
  "\253\310-\33\10A\10\253\310UC\251\0B\10\253\310\250\264\322\2C\10\253\310U\62U\0D\10\253"
  "\310\250d-\0E\10\253\310\214\250\342\0F\10\253\310\214\250b\4G\10\253\310\315\244\222\0H\10\253"
  "\310$\65\224\12I\7\253\310\254X\15J\7\253\310\226\252\2K\10\253\310$\265\222\12L\7\253\310\304"
  "\346\0M\10\253\310\244\61\224\12N\10\253\310\252\241$\0O\7\253\310UV\5P\10\253\310\250\264b"
  "\4Q\10\263\307UV\15\2R\10\253\310\250\264\222\12S\10\253\310m\220\301\2T\7\253\310\254\330\2"
  "U\7\253\310$\327\10V\10\253\310$k\244\4W\10\253\310$\65\206\12X\10\253\310$\325R\1Y"
  "\10\253\310$UV\0Z\7\253\310\314T\16[\6\352\310\254J\134\11\253\310\304\14\62\210\1]\6\252"
  "\310\250j^\5\223\313\65_\5\213\307\14`\6\322\313\304\0a\7\243\310-\225\4b\10\253\310D\225"
  "\324\2c\7\243\310\315\14\4d\10\253\310\246\245\222\0e\6\243\310USf\10\253\310\246\264b\2g"
  "\10\253\307\255$\27\0h\10\253\310D\225\254\0i\10\253\310e$\323\0j\10\263\307fX.\0k"
  "\10\253\310\304\264\222\12l\7\253\310\310\326\0m\10\243\310\244\241T\0n\7\243\310\250d\5o\7\243"
  "\310U\252\2p\10\253\307\250\264b\4q\10\253\307-\225d\0r\10\243\310\244\25#\0s\10\243\310"
  "\215\14\26\0t\10\253\310\245\25\63\10u\7\243\310$+\11v\7\243\310$\253\2w\10\243\310$\65"
  "T\0x\7\243\310\244\62\25y\10\253\307$\225\344\2z\7\243\310\314\224\6{\10\263\307\246$k\20"
  "|\6\351\310\14\1}\11\263\307d\20UL\21~\7\224\313%\225\0\304\10\253\310\244\326P\1\326\10"
  "\253\310\244\226\252\0\334\11\253\310\244\14\222\32\1\337\10\263\307U+\15\11\344\10\253\310\244\214V\22\366"
  "\10\253\310\244\214\272\0\374\11\253\310\244\14\222J\2\0\0\0\4\377\377\0";
