Hardi-St/Zugzielanzeiger_mit_Arduino/Src/Beta/Bahnsteiganzeige_Hardi/5x8_t_german.h

/*
  Fontname: -Misc-Fixed-Medium-R-Normal--8-80-75-75-C-50-ISO10646-1
  Copyright: Public domain font.  Share and enjoy.
  Glyphs: 102/1426
  BBX Build Mode: 0
*/
const uint8_t u8g2_font_5x8_t_german[952] U8G2_FONT_SECTION("u8g2_font_5x8_t_german") = 
  "f\0\2\2\3\4\3\4\4\5\10\0\377\6\377\6\0\1&\2M\3\233 \5\0~\3!\7\61c"
  "\63R\0\42\7\233n\223\254\0#\15=bW\246\64T\65T\231\22\0$\15=b\233\301\252\301\6"
  ")m\20\1%\10\253f\23Sg\0&\12<b\27S\263j\246\0'\5\31o\63(\7\262b\247"
  "\232\1)\10\262b\23S\245\0*\12,b\23\223\32I\305\0+\12-b\233Q\34\62\243\10,\7"
  "\233^\247J\0-\6\14j\63\2.\7\233^\227V\2/\12\64b\17\62\210m\220\1\60\10\263b"
  "W\271*\0\61\7\263b\227dk\62\13\64b\247b\6Ie\60\2\63\12\64b\63b\324H&\5"
  "\64\12\64b\33U\65b\6\11\65\12\64b\63\64\330H&\5\66\12\64b\247\62XQ&\5\67\14"
  "\64b\63\62\210\31\304\14\42\0\70\12\64b\247bRQ&\5\71\12\64b\247\242L\33$\5:\7"
  "\252b\63\342\10;\10\263^g#U\2<\11\263b\233\312\14\62\10=\10\34f\63\62\32\1>\12"
  "\263b\223A\6\61\225\0\77\11\263b\327L\31&\0@\14E^+\243\134I%YC\5A\11\64"
  "b\247\242\34S\6B\12\64b\263\342HQ\216\4C\13\64b\247\242\6\31\304\244\0D\11\64b\263"
  "\242s$\0E\13\64b\63\64X\31d\60\2F\13\64b\63\64X\31d\220\1G\12\64b\247\242"
  "\6i&\5H\11\64b\23\345\230f\0I\7\263b\263bkJ\12\64b\67\63\310 \225\21K\11"
  "\64b\23U\222\251\63L\14\64b\223A\6\31d\220\301\10M\11\64b\23\307\21\315\0N\11\64b"
  "\23\327Xg\0O\11\64b\247\242\63)\0P\12\64b\263\242\34)\203\14Q\11<^\247\242\134n"
  "\24R\12\64b\263\242\34)\312\0S\12\64b\247b\312\250L\12T\10\263b\263b\27\0U\10\64"
  "b\23=\223\2V\11\64b\23\235I*\0W\11\64b\23\315q\304\0X\12\64b\23e\222*\312"
  "\0Y\15\65b\223\201\6\251\6\31e\24\1Z\12\64b\63\62\210m\60\2[\7\263b\63bs\134"
  "\14\64b\223AF\31e\224A\0]\7\263b\63\233#^\6\223r\327\0_\6\14^\63\2`\6"
  "\222r\23\3a\10$b\67\242L\3b\13\64b\223A\6+\312\221\0c\7\243b\67\63\20d\12"
  "\64b\17\62H#\312\64e\11$b\247\322\310@\1f\11\64b[\225\63\203\10g\12,^\247b"
  "\332 )\0h\12\64b\223A\6+\232\1i\10\263b\227\221\254\6j\11\273^\233a\251*\0k"
  "\13\64b\223A\6q\244(\3l\7\263b#\273\6m\11%b\243Z*\251\2n\7$b\263\242"
  "\31o\10$b\247\242L\12p\12,^\263\342H\31d\0q\12,^\67b\332 \203\0r\11$"
  "b\223\222\15\62\0s\10\243b\67\62X\0t\13\64b\227A\234\31\244\230\0u\7$b\23\315\64"
  "v\7\243b\223\254\12w\11%b\223\201J\252\13x\10$b\23\223T\61y\12,^\23e\32\61"
  ")\0z\10$b\63b\71\2{\13<b\253\62J\32\305\214\4|\5\61cs}\14<b\243Q"
  "\314He\224$\0~\7\24r\227T\2\304\12<b\23\63TqL\31\326\12<b\23\63T\321L"
  "\12\334\12<b\23\63\212\316\244\0\337\11\64b\247\242\352T\11\344\11\64bW\303\21e\32\366\12\64"
  "b\23\63TQ&\5\374\11\64b\23\63\212f\32\0\0\0\4\377\377\0";
