Hardi-St/Zugzielanzeiger_mit_Arduino/(commit log)

2020-10-03 Initial upload
    [Configuration.h, OLED_Adapter.brd, OLED_Adapter.sch, OLED_Adapter_15x.brd, OLED_Adapter_Alle_Bauteile.brd, OLED_Adapter_Alle_Bauteile.sch, OLED_Adapter_ein_Display2.brd, OLED_Adapter_ein_Display2.sch]
2020-11-07 Korrektur Werte der Bauteile in der Beschreibung.
